cfbird/usb3-sdr/notes/u12sw/u12sw_open.png

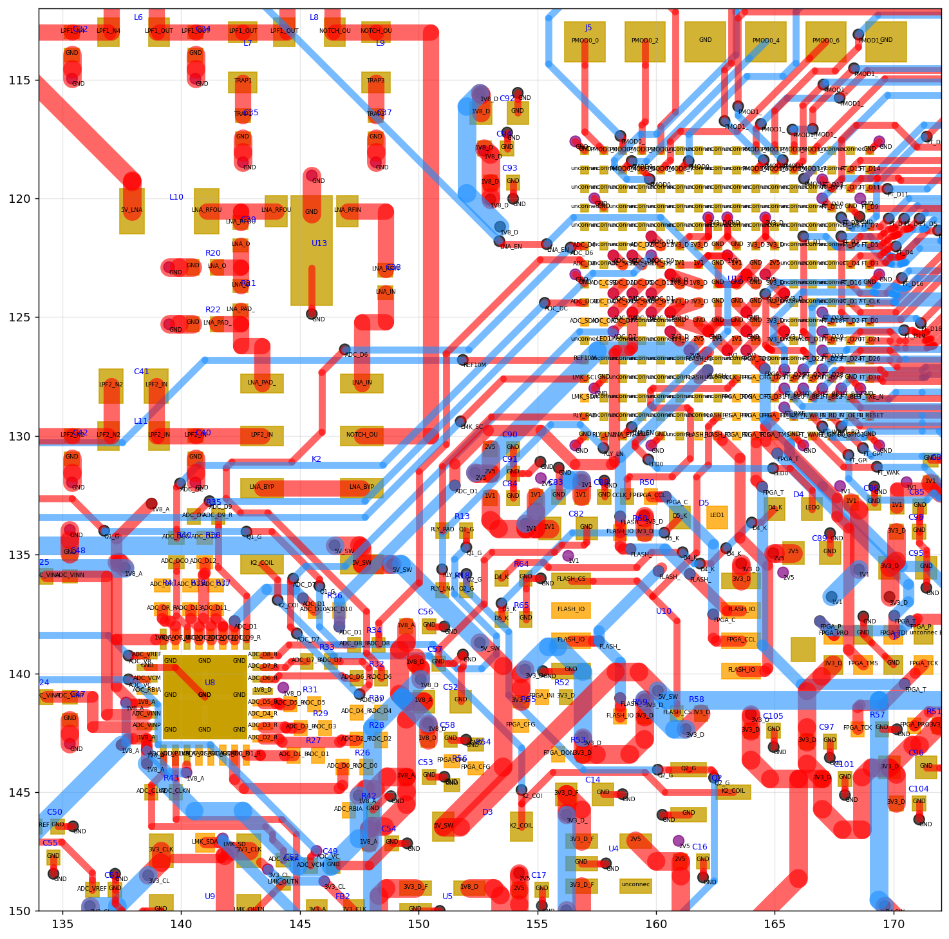
notes/u12sw/u12sw_open.png
