cfbird/usb3-sdr/notes/math.md

# USB3 Direct-Sampling SDR Receiver — Parametric Math & System Budgets

**Author**: AGY (Gemini 4 Argon)  
**Project**: `usb3-sdr` (HF / low-VHF Direct-Sampling SDR, target BOM < $150)  
**Status**: All derivations and numerical tables **VERIFIED** via closed-form analysis and executable Python/SciPy verification (`notes/verify_math.py`).

---

## 1. USB3 Throughput Budget (FX3 vs. FT601)

### 1.1 Interface & Practical Host Ceiling
Both Cypress/Infineon **EZ-USB FX3 (`CYUSB3014`)** and FTDI **FT601Q** expose a 32-bit synchronous parallel bus at up to $f_{\text{bus}} = 100\text{ MHz}$ ($400\text{ MB/s}$ hard wire ceiling, where $1\text{ MB/s} = 10^6\text{ B/s}$; $1\text{ MiB/s} = 2^{20}\text{ B/s} \approx 1.0486\text{ MB/s}$):
- **FX3 (32-bit GPIF II @ 100 MHz)**: **350 – 380 MB/s** ($333.8\text{ – }362.4\text{ MiB/s}$) sustained bulk-IN throughput (512 KB internal SRAM allows multi-buffered DMA to survive host xHCI scheduling latency).
- **FT601 (32-bit FIFO @ 100 MHz)**: **300 – 340 MB/s** ($286.1\text{ – }324.2\text{ MiB/s}$) claimed ceiling, often **240 – 300 MB/s** in sustained cross-platform streaming unless the FPGA provides deep FIFO buffering (FT601 only has 16 KB internal buffer).

### 1.2 Raw Real ADC Streaming Fit
For sample rate $f_s$ (MSPS) and wire bit-width $B_{\text{wire}}$ (bits/sample):
$$R_{\text{byte}} = f_s \cdot \frac{B_{\text{wire}}}{8}\quad [\text{MB/s}]$$

| ADC Rate $f_s$ | 16-bit Unpacked ($2\text{ B/s}$) | 14-bit Packed ($1.75\text{ B/s}$) | 12-bit Packed ($1.5\text{ B/s}$) | FX3 Fit ($350\text{–}380\text{ MB/s}$) | FT601 Fit ($300\text{–}340\text{ MB/s}$) |
| :--- | :--- | :--- | :--- | :--- | :--- |
| **65 MSPS** | $130.0\text{ MB/s}$ ($124.0\text{ MiB/s}$) | $113.75\text{ MB/s}$ | $97.50\text{ MB/s}$ | **PASS** (34–37% bus) | **PASS** (38–43% bus) |
| **105 MSPS** | $210.0\text{ MB/s}$ ($200.3\text{ MiB/s}$) | $183.75\text{ MB/s}$ | $157.50\text{ MB/s}$ | **PASS** (55–60% bus) | **PASS** (62–70% bus) |
| **125 MSPS** | $250.0\text{ MB/s}$ ($238.4\text{ MiB/s}$) | $218.75\text{ MB/s}$ | $187.50\text{ MB/s}$ | **PASS** (66–71% bus) | **PASS / Tight** (74–83%*) |
| **130 MSPS** | $260.0\text{ MB/s}$ ($248.0\text{ MiB/s}$) | $227.50\text{ MB/s}$ | $195.00\text{ MB/s}$ | **PASS** (68–74% bus) | **MARGINAL** (76–87%*) |
| **160 MSPS** | $320.0\text{ MB/s}$ ($305.2\text{ MiB/s}$) | $280.00\text{ MB/s}$ | $240.00\text{ MB/s}$ | **PASS** (84–91% bus) | **FAIL (16b)** / **PASS (14b/12b)** |
| **Max Rate** | **FX3: 175–190 MSPS**<br>**FT601: 150–170 MSPS** | **FX3: 200–217 MSPS**<br>**FT601: 171–194 MSPS** | **FX3: 233–253 MSPS**<br>**FT601: 200–226 MSPS** | Hard GPIF ceiling:<br>$200\text{ MSPS}$ @ 16b | *Requires large FPGA FIFO / SDRAM on FT601 |

### 1.3 FPGA DDC Complex IQ Streaming ($16\text{I} + 16\text{Q} = 4\text{ Bytes/sample}$)
For complex IQ output rate $f_{s,\text{IQ}} = f_s / R$ and an 80% alias-free usable passband ($B_{80\%} = 0.8 \, f_{s,\text{IQ}}$):
$$R_{\text{byte,IQ}} = 4 \, f_{s,\text{IQ}}, \qquad f_{s,\text{IQ},\max} = \frac{R_{\text{USB},\max}}{4}$$
- **FX3 ($350\text{–}380\text{ MB/s}$)**:
  - Max complex sample rate: $f_{s,\text{IQ},\max} = \mathbf{87.5\text{ – }95.0\text{ MSPS}}$ (usable alias-free BW $B_{80\%} = \mathbf{70.0\text{ – }76.0\text{ MHz}}$).
- **FT601 ($300\text{–}340\text{ MB/s}$)**:
  - Max complex sample rate: $f_{s,\text{IQ},\max} = \mathbf{75.0\text{ – }85.0\text{ MSPS}}$ (usable alias-free BW $B_{80\%} = \mathbf{60.0\text{ – }68.0\text{ MHz}}$).
- **Key Architectural Observation**: Because 16-bit real samples at $f_s$ ($2\text{ B/sample}$, Nyquist $f_s/2$) and 16I+16Q complex samples at $f_{s,\text{IQ}} = f_s/2$ ($4\text{ B/sample}$, Nyquist $f_{s,\text{IQ}} = f_s/2$) have the **exact same byte rate per Hz of Nyquist bandwidth** ($4\text{ B/s per Hz}$), at $f_s = 125\text{ MSPS}$ the entire 1st Nyquist zone ($62.5\text{ MHz}$) fits over USB3 raw ($250\text{ MB/s}$). Using the FPGA DDC for decimation $R \in \{2, 4, 8, 16, 32, 64\}$ provides:
  1. Host CPU offload and lower USB EMI/power ($R=64 \Rightarrow f_{s,\text{IQ}} = 1.953125\text{ MSPS} \Rightarrow \mathbf{7.8125\text{ MB/s}}$ per slice, $B_{80\%} = \mathbf{1.5625\text{ MHz}}$).
  2. Multi-slice independent DDCs (up to **44–48 slices** at $1.953\text{ MSPS}$ fit in FX3 bandwidth; FPGA DSP-limited first).
  3. Ability to stream **24I+24Q ($6\text{ B/sample}$)** after decimation to preserve processing-gain dynamic range (fits up to $f_{s,\text{IQ}} = 58.3\text{–}63.3\text{ MSPS}$ on FX3).

---

## 2. Clock Jitter Budget

### 2.1 Derivation
Let the ADC low-frequency thermal + quantization SNR be $\text{SNR}_0 = 77.0\text{ dBFS}$ and the maximum allowed degradation be $\Delta\text{SNR} = 1.0\text{ dB}$ ($\text{SNR}_{\text{total}} \ge 76.0\text{ dBFS}$).
For a full-scale tone at $f_{\text{in}}$, RMS timing jitter $t_{j,\text{total}}$ produces jitter SNR:
$$\text{SNR}_{j} = \frac{1}{(2\pi f_{\text{in}} t_{j,\text{total}})^2}$$
Combining uncorrelated thermal/quantization noise and jitter noise:
$$10^{-\text{SNR}_{\text{total}}/10} = 10^{-\text{SNR}_0/10} + (2\pi f_{\text{in}} t_{j,\text{total}})^2 \le 10^{-(\text{SNR}_0 - \Delta\text{SNR})/10}$$
Solving for $t_{j,\text{total}}$:
$$t_{j,\text{total}} \le \frac{10^{-\text{SNR}_0/20}\sqrt{10^{\Delta\text{SNR}/10} - 1}}{2\pi f_{\text{in}}}, \qquad \text{SNR}_{j,\text{min}} = \text{SNR}_0 - 10\log_{10}\!\left(10^{\Delta\text{SNR}/10}-1\right) = \mathbf{82.87\text{ dBFS}}$$
Decomposing into internal ADC aperture jitter $t_{j,\text{ADC}}$ and external clock + buffer jitter $t_{j,\text{clk}}$:
$$t_{j,\text{clk}} \le \sqrt{t_{j,\text{total}}^2 - t_{j,\text{ADC}}^2}$$

### 2.2 Jitter Budget Table ($\text{SNR}_0 = 77\text{ dBFS}$, $\Delta\text{SNR} \le 1\text{ dB}$)

| Input Freq $f_{\text{in}}$ | Max Total RMS Jitter $t_{j,\text{total}}$ | Max External Clock Jitter ($t_{j,\text{ADC}} = 70\text{ fs}$, e.g. LTC2208) | Max External Clock Jitter ($t_{j,\text{ADC}} = 100\text{ fs}$, e.g. AD9265/LTC2165) | Max External Clock Jitter ($t_{j,\text{ADC}} = 150\text{ fs}$) | Hardware Feasibility |
| :--- | :--- | :--- | :--- | :--- | :--- |
| **30 MHz** (HF top) | **381.3 fs** | **374.8 fs** | **368.0 fs** | **350.6 fs** | Easy: standard low-PN XO (e.g. Crystek CCHD-957 ~82 fs, Abracon ASFLMB/NDK <150 fs). |
| **60 MHz** (6m VHF) | **190.7 fs** | **177.3 fs** | **162.3 fs** | **117.7 fs** | Moderate: requires dedicated low-phase-noise crystal XO + clean LDO; **never route clock through FPGA**. |
| **150 MHz** (2m VHF undersampled) | **76.3 fs** | **30.3 fs** | **Impossible at 0 dBFS** ($\Delta\text{SNR} = 1.60\text{ dB}$ even w/ $0\text{ fs}$ clock!) | **Impossible at 0 dBFS** ($\Delta\text{SNR} = 2.99\text{ dB}$ w/ $0\text{ fs}$ clock) | At 150 MHz, a full-scale $0\text{ dBFS}$ blocker is aperture-jitter limited. However, if bandpass filtering keeps max in-band signals $\le -6\text{ dBFS}$, allowable $t_{j,\text{total}}$ doubles to **152.5 fs**! |

---

## 3. Dynamic Range, MDS, Front-End NF, and LNA Requirements

### 3.1 Noise Spectral Density (NSD) & Processing Gain
Given $\text{SNR}_0 = 77.0\text{ dBFS}$ at $f_s = 125\text{ MSPS}$ ($B_{\text{Nyq}} = f_s/2 = 62.5\text{ MHz}$, $10\log_{10}(f_s/2) = 77.9588\text{ dB}\cdot\text{Hz}$) and full-scale input power $P_{\text{FS}} = +4.0\text{ dBm}$:
*(Note on $P_{\text{FS}}$: $2\text{ V}_{\text{pp}} = 0.7071\text{ V}_{\text{rms}}$ across a $200\,\Omega$ differential ADC input via a lossless 1:4 impedance transformer from $50\,\Omega$ equals $P_{\text{FS}} = \frac{0.5\text{ V}^2}{200\,\Omega} = 2.5\text{ mW} = \mathbf{+3.98\text{ dBm}} \approx +4.0\text{ dBm}$; if driven via a 1:1 balun into $50\,\Omega$, $2\text{ V}_{\text{pp}}$ is $+10.0\text{ dBm}$. Below we use the specified $P_{\text{FS}} = +4.0\text{ dBm}$.)*
$$\text{NSD}_{\text{dBFS/Hz}} = -\text{SNR}_0 - 10\log_{10}(f_s/2) = -77.0 - 77.9588 = \mathbf{-154.96\text{ dBFS/Hz}}$$
$$\text{NSD}_{\text{dBm/Hz}} = P_{\text{FS}} + \text{NSD}_{\text{dBFS/Hz}} = +4.0 - 154.9588 = \mathbf{-150.96\text{ dBm/Hz}}$$
For resolution bandwidth $B$:
- **Processing Gain**: $G_p(B) = 10\log_{10}\!\left(\frac{f_s/2}{B}\right) = 77.9588 - 10\log_{10}(B)\text{ dB}$
- **Dynamic Range in BW $B$**: $\text{DR}(B) = \text{SNR}_0 + G_p(B) = 154.9588 - 10\log_{10}(B)\text{ dB}$
- **MDS (0 dB SNR noise floor, standard SDR definition)**: $\text{MDS}_{0\text{dB}}(B) = \text{NSD}_{\text{dBm/Hz}} + 10\log_{10}(B)$
- **MDS (3 dB SNR definition)**: $\text{MDS}_{3\text{dB}}(B) = \text{MDS}_{0\text{dB}}(B) + 3.0\text{ dB}$

| Bandwidth $B$ | $10\log_{10}(B)$ | Processing Gain $G_p$ | Dynamic Range $\text{DR}(B)$ | Noise Floor in dBFS | $\text{MDS}_{0\text{dB}}$ (Noise Floor, dBm) | $\text{MDS}_{3\text{dB}}$ ($\text{SNR}=3\text{ dB}$, dBm) |
| :--- | :--- | :--- | :--- | :--- | :--- | :--- |
| **2.4 kHz** (SSB) | $33.80\text{ dB}\cdot\text{Hz}$ | **44.16 dB** | **121.16 dB** | $-121.16\text{ dBFS}$ | **$-117.16\text{ dBm}$** | $-114.16\text{ dBm}$ |
| **10 kHz** (AM) | $40.00\text{ dB}\cdot\text{Hz}$ | **37.96 dB** | **114.96 dB** | $-114.96\text{ dBFS}$ | **$-110.96\text{ dBm}$** | $-107.96\text{ dBm}$ |
| **200 kHz** (WBFM) | $53.01\text{ dB}\cdot\text{Hz}$ | **24.95 dB** | **101.95 dB** | $-101.95\text{ dBFS}$ | **$-97.95\text{ dBm}$** | $-94.95\text{ dBm}$ |
| **2.0 MHz** (Sub-band) | $63.01\text{ dB}\cdot\text{Hz}$ | **14.95 dB** | **91.95 dB** | $-91.95\text{ dBFS}$ | **$-87.95\text{ dBm}$** | $-84.95\text{ dBm}$ |
| **62.5 MHz** (Nyquist) | $77.96\text{ dB}\cdot\text{Hz}$ | **0.00 dB** | **77.00 dB** | $-77.00\text{ dBFS}$ | **$-73.00\text{ dBm}$** | $-70.00\text{ dBm}$ |

### 3.2 Implied Front-End Noise Figure (No LNA)
Relative to $k_B T_0 = -173.975\text{ dBm/Hz}$ at $T_0 = 290\text{ K}$:
$$\text{NF}_{\text{ADC}} = \text{NSD}_{\text{dBm/Hz}} - 10\log_{10}(k_B T_0 / 1\text{ mW}) = -150.9588 - (-173.9752) = \mathbf{23.02\text{ dB}} \quad (F_{\text{ADC}} = 200.3)$$
Including passive anti-alias filter + balun insertion loss $L_{\text{pass}} \approx 1.5\text{–}2.0\text{ dB}$ ahead of the ADC, the passive (no-LNA) cascade noise figure is:
$$\text{NF}_{\text{no-LNA}} = \text{NF}_{\text{ADC}} + L_{\text{pass}} = \mathbf{24.5\text{ – }25.0\text{ dB}}$$

### 3.3 LNA Gain & NF to Get MDS Within 3 dB of Antenna Noise at 30 MHz
**External Noise Assumptions (ITU-R P.372-16 at $f = 30\text{ MHz}$)**:
In ITU-R P.372-16, median external noise factor $F_{am} = c - d\log_{10}(f_{\text{MHz}})$ above $k_B T_0$ at $f = 30\text{ MHz}$ gives three standard benchmarks:
1. **ITU Rural (Man-Made)**: $F_a = 67.2 - 27.7\log_{10}(30) = \mathbf{26.28\text{ dB}}$ ($\text{NSD}_{\text{ant}} = -147.70\text{ dBm/Hz}$).
2. **ITU Galactic Noise Limit (Sky floor at 30 MHz)**: $F_a = 52.0 - 23.0\log_{10}(30) = \mathbf{18.03\text{ dB}}$ ($\text{NSD}_{\text{ant}} = -155.95\text{ dBm/Hz}$).
3. **ITU Quiet Rural**: $F_a = 53.6 - 28.6\log_{10}(30) = \mathbf{11.35\text{ dB}}$ ($\text{NSD}_{\text{ant}} = -162.63\text{ dBm/Hz}$).

**Condition for System MDS Within 3 dB of Antenna Noise**:
Total input-referred noise factor is $f_{\text{total}} = f_a + f_{\text{sys}} - 1$.
- **Criterion A (System MDS degrades $\le 3.0\text{ dB}$ vs. ideal noiseless receiver on same antenna)**:
  $$\frac{f_a + f_{\text{sys}} - 1}{f_a} \le 10^{3/10} \approx 1.9953 \implies f_{\text{sys}} \le 1 + 0.9953 \, f_a \approx f_a \quad (\text{i.e., } \text{NF}_{\text{sys}} \le F_a)$$
- **Criterion B (Stricter: Receiver internal noise floor is $3\text{ dB}$ *below* antenna noise, giving only $1.76\text{ dB}$ total MDS degradation)**:
  $$\text{NF}_{\text{sys}} \le F_a - 3.0\text{ dB}$$

By Friis's formula for an LNA of gain $G_{\text{LNA}}$ and noise factor $f_{\text{LNA}}$ driving post-LNA stage $f_2 = 10^{(\text{NF}_{\text{ADC}} + L_{\text{post}})/10}$:
$$f_{\text{sys}} = f_{\text{LNA}} + \frac{f_2 - 1}{g_{\text{LNA}}} \implies G_{\text{LNA,min}} = 10\log_{10}\!\left(\frac{f_2 - 1}{f_{\text{sys,target}} - f_{\text{LNA}}}\right)$$

| External Noise Model @ 30 MHz | $F_a$ (dB/$k T_0$) | Target $\text{NF}_{\text{sys}}$ (Crit. A: +3 dB MDS) | Min $G_{\text{LNA}}$ (Crit. A, bare ADC / w/ $1.5\text{ dB}$ loss)* | Target $\text{NF}_{\text{sys}}$ (Crit. B: Rx $-3\text{ dB}$ vs Ant) | Min $G_{\text{LNA}}$ (Crit. B, bare ADC / w/ $1.5\text{ dB}$ loss)* |
| :--- | :--- | :--- | :--- | :--- | :--- |
| **ITU Rural Man-Made** | **26.28 dB** | $\le 26.27\text{ dB}$ | **0 dB (No LNA!)** / **0 dB** | $\le 23.28\text{ dB}$ | **0 dB** / **1.3 dB** |
| **ITU Galactic (Sky Limit)** | **18.03 dB** | $\le 18.07\text{ dB}$ | **5.1 dB** / **6.6 dB** | $\le 15.03\text{ dB}$ | **8.2 dB** / **9.8 dB** |
| **ITU Quiet Rural** | **11.35 dB** | $\le 11.64\text{ dB}$ | **12.0 dB** / **13.5 dB** | $\le 8.35\text{ dB}$ | **16.1 dB** / **17.6 dB** |
| **Low-VHF 50 MHz (Galactic)** | **12.92 dB** | $\le 13.13\text{ dB}$ | **10.3 dB** / **11.8 dB** | $\le 9.92\text{ dB}$ | **14.0 dB** / **15.5 dB** |

*\*Evaluated for $\text{NF}_{\text{LNA}} = 3.0\text{ dB}$ (insensitive to $\text{NF}_{\text{LNA}} \in [1.5, 4.0]\text{ dB}$ to within $\pm 0.3\text{ dB}$).*
- **Design Takeaway**: Under literal **ITU Rural man-made noise ($F_a = 26.3\text{ dB}$)** with an efficient antenna, the bare ADC ($\text{NF} = 23.0\text{ dB}$) already achieves MDS within $1.7\text{ dB}$ of antenna noise with **no LNA**. To hit **Galactic / Quiet Rural limits at 30–54 MHz** (or compensate inefficient small antennas), include a **switchable 12–16 dB LNA ($\text{NF} \le 2.5\text{ dB}$, OIP3 $\ge +35\text{ dBm}$)** with a **0 dB bypass** for strong-signal lower-HF operation.

---

## 4. FPGA DDC Design (125 MSPS $\to$ ~2 MSPS) & ECP5 Fit Check

### 4.1 CIC Decimator Math ($f_s = 125\text{ MSPS}$, $B_{\text{in}} = 16\text{ bits}$, $M = 1$)
For an $N$-stage CIC decimator with decimation ratio $R_{\text{CIC}}$ and differential delay $M=1$:
- **Transfer Function Magnitude**:
  $$|H(f)| = \left|\frac{\sin(\pi R_{\text{CIC}} f / f_s)}{R_{\text{CIC}} \sin(\pi f / f_s)}\right|^N$$
- **Exact Bit Growth (no internal overflow)**:
  $$B_{\text{growth}} = \lceil N \log_2(R_{\text{CIC}} M) \rceil, \qquad B_{\max} = B_{\text{in}} + B_{\text{growth}} = 16 + \lceil N \log_2(R_{\text{CIC}}) \rceil$$
- **Why Multi-Stage ($R_{\text{CIC}} = 32 + 2:1\text{ CFIR}$, or $R_{\text{CIC}} = 16 + 2:1\text{ HB} + 2:1\text{ CFIR}$) Beats Direct $R_{\text{CIC}} = 64$**:
  - Total decimation $R_{\text{total}} = 64$ gives $f_{\text{out}} = 125 / 64 = \mathbf{1.953125\text{ MSPS}}$ and an 80% usable passband of $B_{80\%} = 0.8 \, f_{\text{out}} = \mathbf{1.5625\text{ MHz}}$ (one-sided passband edge $f_p = \mathbf{781.25\text{ kHz}}$).
  - If the CIC decimates **all the way to $f_{\text{out}}$** ($R_{\text{CIC}} = 64$), then $f_p = 0.40 \, f_{\text{CIC,out}}$ and the worst-case first alias folding into the passband is at $f_{\text{alias}} = f_{\text{CIC,out}} - f_p = 0.60 \, f_{\text{CIC,out}}$. Because $\sin(0.6\pi) = \sin(0.4\pi)$, the alias rejection relative to the passband edge is only $(0.6/0.4)^N = 1.5^N$ ($3.52\text{ dB/stage}$)!
  - If instead the CIC decimates by **$R_{\text{CIC}} = 32$** (to $3.90625\text{ MSPS}$) followed by a **$2:1$ Compensating FIR (CFIR)** to $1.953125\text{ MSPS}$, then at the CIC output $f_p = 0.20 \, f_{\text{CIC,out}}$ and $f_{\text{alias}} = 0.80 \, f_{\text{CIC,out}}$, giving $(0.8/0.2)^N = 4^N$ ($12.04\text{ dB/stage}$) alias rejection!
  - Even better, **$R_{\text{CIC}} = 16$** (to $7.8125\text{ MSPS}$) $\to$ **$2:1$ Half-Band** $\to$ **$2:1$ CFIR** puts $f_p = 0.10 \, f_{\text{CIC,out}}$ and $f_{\text{alias}} = 0.90 \, f_{\text{CIC,out}}$, giving $>95\text{ dB}$ alias rejection at $N=5$.

### 4.2 CIC Performance Comparison Table ($f_{\text{out}} = 1.953125\text{ MSPS}$, $B_{80\%} = 1.5625\text{ MHz}$)

| Architecture | CIC Order $N$ | $R_{\text{CIC}}$ | Bit Growth $B_{\text{growth}}$ | Accumulator Width $B_{\max}$ | Passband Droop @ $f_p = 781.25\text{ kHz}$ | 1st Alias Rejection @ $f_{\text{CIC}} - f_p$ (vs. DC) | 1st Alias Rejection (vs. Passband Edge) |
| :--- | :--- | :--- | :--- | :--- | :--- | :--- | :--- |
| **Arch 1: Direct CIC** ($R_{\text{CIC}}=64 \to 1:1\text{ CFIR}$) | $N=4$ | 64 | $24\text{ bits}$ | $40\text{ bits}$ | $-9.68\text{ dB}$ | $23.76\text{ dB}$ | $14.08\text{ dB}$ (Poor) |
| **Arch 1: Direct CIC** ($R_{\text{CIC}}=64 \to 1:1\text{ CFIR}$) | $N=5$ | 64 | $30\text{ bits}$ | $46\text{ bits}$ | $-12.10\text{ dB}$ | $29.70\text{ dB}$ | $17.61\text{ dB}$ (Poor) |
| **Arch 1: Direct CIC** ($R_{\text{CIC}}=64 \to 1:1\text{ CFIR}$) | $N=6$ | 64 | $36\text{ bits}$ | $52\text{ bits}$ | $-14.52\text{ dB}$ | $35.64\text{ dB}$ | $21.13\text{ dB}$ (Poor) |
| **Arch 2: CIC + 2:1 CFIR** ($R_{\text{CIC}}=32 \to 2:1\text{ CFIR}$) | **$N=5$** | **32** | **25 bits** | **41 bits** | **$-2.89\text{ dB}$** | **63.06 dB** | **60.16 dB** (Good) |
| **Arch 2: CIC + 2:1 CFIR** ($R_{\text{CIC}}=32 \to 2:1\text{ CFIR}$) | **$N=6$** | **32** | **30 bits** | **46 bits** | **$-3.47\text{ dB}$** | **75.67 dB** | **72.20 dB** (Recommended) |
| **Arch 3: CIC + HB + CFIR** ($R_{\text{CIC}}=16 \to 2:1\text{ HB} \to 2:1\text{ CFIR}$) | **$N=5$** | **16** | **20 bits** | **36 bits** | **$-0.71\text{ dB}$** | **95.91 dB** | **95.20 dB** (Best DR) |
| **Arch 3: CIC + HB + CFIR** ($R_{\text{CIC}}=16 \to 2:1\text{ HB} \to 2:1\text{ CFIR}$) | **$N=6$** | **16** | **24 bits** | **40 bits** | **$-0.86\text{ dB}$** | **115.10 dB** | **114.24 dB** (Ultra-clean) |

*(Note: If exact $2.016\text{ MSPS}$ is desired, replace $R_{\text{CIC}}=32$ with $R_{\text{CIC}}=31$ in Arch 2: $B_{\text{growth}} = \lceil 5\log_2 31 \rceil = 25\text{ bits}$, droop $= -2.89\text{ dB}$, alias rejection $= 63.05\text{ dB}$.)*

### 4.3 ECP5 Multiplier Fit Check (LFE5U-25F: 28 mults vs. LFE5U-45F: 72 mults)
For **one complex DDC channel** at $f_{\text{clk}} = f_s = 125\text{ MHz}$:
1. **NCO**: **0 multipliers** (LUT-based 20-bit phase / 18-bit amplitude CORDIC takes ~900 LUT4s; or **1 multiplier** + 2 EBR18k RAMs for Taylor-interpolated quarter-wave LUT).
2. **Real-to-Complex Mixer**: **2 multipliers** ($I = x[n]\cos\omega_0 n$, $Q = -x[n]\sin\omega_0 n$ at $125\text{ MSPS}$, $16\text{-bit} \times 18\text{-bit}$).
3. **CIC Decimator**: **0 multipliers** (purely shift-and-add; ~350 LUT4s for I+Q with Hogenauer pruning).
4. **Compensating FIR (and optional Half-Band)**:
   - To achieve an 80% usable passband ($f_p = 0.40 \, f_{\text{out}}, f_{\text{stop}} = 0.60 \, f_{\text{out}} \implies \Delta f / f_{\text{in,CFIR}} = 0.10$) with $<0.05\text{ dB}$ ripple and $>85\text{ dB}$ stopband rejection requires **$N_{\text{CFIR}} = 63\text{ taps}$** (32 symmetric tap pairs per I/Q rail).
   - **Time-Multiplexed Polyphase MAC (Recommended FPGA Architecture)**:
     At $f_{\text{out}} = 1.953125\text{ MSPS}$ and $f_{\text{clk}} = 125\text{ MHz}$, there are **$64\text{ clock cycles}$ per output sample**! Using a polyphase MAC running at $125\text{ MHz}$, a 63-tap FIR requires 64 MACs (or 32 symmetric pre-add MACs) per output sample—meaning **1 multiplier for I + 1 multiplier for Q = 2 multipliers total** (or **4 multipliers** if doing 24-bit $\times$ 18-bit double-precision MACs)! Adding a 19-tap Half-Band stage (5 non-zero symmetric taps at $3.906\text{ MSPS}$, i.e. 32 cycles/sample) adds **1–2 multipliers**.
   - **Naive Unfolded / Parallel FIR (Anti-pattern)**:
     Unrolling all 32 symmetric taps in parallel without time-multiplexing takes $32 \times 2 = 64\text{ multipliers}$ for the CFIR alone.

| DDC Implementation Style | NCO | Mixer (Real $\to$ IQ) | CIC | HB + CFIR (63-tap) | Total $18\times 18$ Mults / DDC | LFE5U-25F Fit (28 Mults) | LFE5U-45F Fit (72 Mults) |
| :--- | :--- | :--- | :--- | :--- | :--- | :--- | :--- |
| **TDM Polyphase MAC (18x18)** | 0 (CORDIC) | 2 | 0 | 2–4 | **4 – 6** | **PASS** (14–21% DSP; fits **4–7 DDCs**) | **PASS** (6–8% DSP; fits **12–18 DDCs**) |
| **TDM Polyphase MAC (24x18 Hi-DR + LUT NCO)** | 1 | 2 | 0 | 4–6 | **7 – 9** | **PASS** (25–32% DSP; fits **3–4 DDCs**) | **PASS** (10–13% DSP; fits **8–10 DDCs**) |
| **Unfolded Parallel Symmetric FIR** | 0–1 | 2 | 0 | 64 | **66 – 67** | **FAIL** (236% DSP) | **MARGINAL** (93% DSP; 1 DDC max) |

---

## 5. Anti-Alias Low-Pass Filter ($0\text{–}55\text{ MHz}$ Passband, $\ge 70\text{ MHz}$ Stopband)

### 5.1 Required Stopband Attenuation at $f_{\text{stop}} = 70\text{ MHz}$
At $f_s = 125\text{ MSPS}$, signals at $f \ge f_s - f_p = 125 - 55 = \mathbf{70\text{ MHz}}$ fold directly into the $0\text{–}55\text{ MHz}$ passband.
From Item 3, in a $B = 10\text{ kHz}$ bin:
- Noise floor is **$-114.96\text{ dBFS}$** ($= \mathbf{-110.96\text{ dBm}}$ for $P_{\text{FS}} = +4\text{ dBm}$).
- Depending on the maximum expected out-of-band blocker level at $\ge 70\text{ MHz}$ (notably FM broadcast $88\text{–}108\text{ MHz}$):
  1. **Full-Scale Blocker ($0\text{ dBFS} = +4\text{ dBm}$) $\to$ $10\text{ kHz}$ noise floor ($-114.96\text{ dBFS}$)**:
     $$A_{\text{stop}} = 0 - (-114.96) = \mathbf{114.96\text{ dB}} \approx \mathbf{115\text{ dB}}$$
  2. **Strong VHF/FM Blocker ($-20\text{ dBm} = -24\text{ dBFS}$) $\to$ $10\text{ kHz}$ noise floor ($-110.96\text{ dBm}$)**:
     $$A_{\text{stop}} = -20 - (-110.96) = \mathbf{90.96\text{ dB}} \approx \mathbf{91\text{ dB}}$$
  3. **Full-Scale Blocker ($0\text{ dBFS}$) $\to$ Full-Nyquist ADC Thermal Floor ($-77\text{ dBFS}$)**:
     $$A_{\text{stop}} = \mathbf{77.0\text{ dB}}$$

### 5.2 Filter Order Derivation & Table ($\Omega_s = f_{\text{stop}} / f_p = 70 / 55 = 1.27273$)
With discrimination factor $d = \sqrt{\frac{10^{A_s/10} - 1}{10^{R_p/10} - 1}}$:
$$N_{\text{Butt}} = \left\lceil\frac{\ln d}{\ln \Omega_s}\right\rceil, \qquad N_{\text{Cheb}} = \left\lceil\frac{\operatorname{arccosh} d}{\operatorname{arccosh} \Omega_s}\right\rceil, \qquad N_{\text{Ellip}} = \left\lceil\frac{K(1/\Omega_s)\,K'(\!1/d)}{K'(1/\Omega_s)\,K(1/d)}\right\rceil$$

| Blocker Scenario | Required $A_{\text{stop}}$ @ $70\text{ MHz}$ | Passband Ripple $R_p$ | Butterworth Order $N$ | Chebyshev (I/II) Order $N$ | Elliptic (Cauer) Order $N$ | Practical Hardware Realization |
| :--- | :--- | :--- | :--- | :--- | :--- | :--- |
| **$0\text{ dBFS}$ ($+4\text{ dBm}$) $\to$ $10\text{ kHz}$ Floor** | **115.0 dB** | $0.5\text{ dB}$<br>$1.0\text{ dB}$ | **60**<br>**58** | **21**<br>**21** | **12**<br>**11** | Single PCB filter cannot hold $115\text{ dB}$ due to ground/parasitic bypass. Use **two cascaded 7th-order Elliptic LPFs** ($2 \times 64\text{ dB} = 128\text{ dB}$) split across the LNA/switch! |
| **$-20\text{ dBm}$ FM Blocker $\to$ $10\text{ kHz}$ Floor** | **91.0 dB** | $0.5\text{ dB}$<br>$1.0\text{ dB}$ | **48**<br>**47** | **17**<br>**17** | **10**<br>**9** | **9th-order Elliptic (Cauer) LPF** (4 inductors, 9 caps) + FM band trap notch at $88\text{–}108\text{ MHz}$. |
| **$0\text{ dBFS}$ $\to$ Nyquist Thermal Floor** | **77.0 dB** | $0.5\text{ dB}$<br>$1.0\text{ dB}$ | **42**<br>**40** | **15**<br>**15** | **9**<br>**8** | **9th-order Elliptic LPF** ($R_p = 0.5\text{ dB}$ gives $84.7\text{ dB}$ @ $70\text{ MHz}$). |

---

## 6. PCB Controlled Impedance (JLCPCB `JLC04161H-7628` 4-Layer Stackup)

### 6.1 Stackup Parameters (`JLC04161H-7628`, 1.6 mm)
- **L1 Copper (1 oz finished)**: $t = 0.035\text{ mm}$ ($1.38\text{ mil}$)
- **L1–L2 Prepreg (1 ply 7628)**: $h = 0.2104\text{ mm} \approx 0.21\text{ mm}$ ($8.28\text{ mil}$), $\varepsilon_r = 4.4$ (note: JLCPCB's calculator uses $\varepsilon_r = 4.6$ for 7628 resin content and includes a coated solder mask layer $\varepsilon_{r,\text{SM}} \approx 3.8, t_{\text{SM}} \approx 20\,\mu\text{m}$).
- Below we report **three cross-checked models** so there is zero ambiguity when comparing against JLCPCB's web calculator:
  1. **Analytical Bare Microstrip** (Hammerstad–Jensen 1980 for SE; Kirschning–Jansen 1984 for Edge-Coupled Diff, $\varepsilon_r = 4.4$).
  2. **2D Laplace Quasi-Static Field Solver (Coated w/ Solder Mask, $\varepsilon_r = 4.4$)**.
  3. **IPC-2141 / Polar Si9000 Coated Equivalent ($\varepsilon_r = 4.6$)** — matches JLCPCB's online impedance calculator within $\pm 0.01\text{ mm}$.

### 6.2 Trace Width & Spacing Table

| Target Impedance | Assumed Gap $s$ | Model 1: Bare Analytical ($\varepsilon_r = 4.4$, H-J / K-J) | Model 2: 2D Field Solver w/ Solder Mask ($\varepsilon_r = 4.4$) | Model 3: Coated / JLC Polar Calc ($\varepsilon_r = 4.6$) | Recommended PCB Layout Rule |
| :--- | :--- | :--- | :--- | :--- | :--- |
| **$50\,\Omega$ Single-Ended** (RF / Clock) | N/A | **$0.373\text{ mm}$** ($14.67\text{ mil}$) | **$0.330\text{ mm}$** ($13.00\text{ mil}$) | **$0.315\text{ – }0.335\text{ mm}$** ($12.4\text{–}13.2\text{ mil}$) | Use **$w = 0.34\text{ mm}$** ($13.4\text{ mil}$) (or **$0.36\text{ mm}$** if solder-mask opening over RF trace). |
| **$90\,\Omega$ Diff** (USB3 SuperSpeed) | **$s = 0.127\text{ mm}$** ($5.0\text{ mil}$) | $0.305\text{ mm}$ ($11.99\text{ mil}$) | $0.232\text{ mm}$ ($9.13\text{ mil}$) | **$0.235\text{ – }0.249\text{ mm}$** ($9.3\text{–}9.8\text{ mil}$) | Use **$w = 0.24\text{ mm}, s = 0.127\text{ mm}$** ($9.5 / 5.0\text{ mil}$) or **$w = 0.26\text{ mm}, s = 0.15\text{ mm}$**. |
| **$90\,\Omega$ Diff** (USB3 SuperSpeed) | **$s = 0.150\text{ mm}$** ($5.9\text{ mil}$) | $0.323\text{ mm}$ ($12.72\text{ mil}$) | $0.248\text{ mm}$ ($9.76\text{ mil}$) | **$0.255\text{ – }0.268\text{ mm}$** ($10.0\text{–}10.6\text{ mil}$) | Good balance of tight coupling and standard $6\text{ mil}$ design rules. |
| **$90\,\Omega$ Diff** (USB3 SuperSpeed) | **$s = 0.200\text{ mm}$** ($7.9\text{ mil}$) | $0.352\text{ mm}$ ($13.88\text{ mil}$) | $0.275\text{ mm}$ ($10.83\text{ mil}$) | **$0.285\text{ – }0.300\text{ mm}$** ($11.2\text{–}11.8\text{ mil}$) | Wider footprint; use only outside BGA/QFN fanout. |
| **$100\,\Omega$ Diff** (LVDS ADC / Clk) | **$s = 0.127\text{ mm}$** ($5.0\text{ mil}$) | $0.239\text{ mm}$ ($9.41\text{ mil}$) | $0.175\text{ mm}$ ($6.89\text{ mil}$) | **$0.180\text{ – }0.195\text{ mm}$** ($7.1\text{–}7.7\text{ mil}$) | Use **$w = 0.185\text{ mm}, s = 0.127\text{ mm}$** ($7.3 / 5.0\text{ mil}$). |
| **$100\,\Omega$ Diff** (LVDS ADC / Clk) | **$s = 0.150\text{ mm}$** ($5.9\text{ mil}$) | $0.256\text{ mm}$ ($10.09\text{ mil}$) | $0.189\text{ mm}$ ($7.44\text{ mil}$) | **$0.195\text{ – }0.214\text{ mm}$** ($7.7\text{–}8.4\text{ mil}$) | Recommended LVDS rule: **$w = 0.20\text{ mm}, s = 0.15\text{ mm}$** ($7.9 / 5.9\text{ mil}$). |
| **$100\,\Omega$ Diff** (LVDS ADC / Clk) | **$s = 0.200\text{ mm}$** ($7.9\text{ mil}$) | $0.284\text{ mm}$ ($11.19\text{ mil}$) | $0.214\text{ mm}$ ($8.43\text{ mil}$) | **$0.225\text{ – }0.240\text{ mm}$** ($8.9\text{–}9.4\text{ mil}$) | Use **$w = 0.23\text{ mm}, s = 0.20\text{ mm}$** if routing space permits. |

---

## 7. Runnable Python Verification Script (`notes/verify_math.py`)

Run `python3 notes/verify_math.py` to reproduce all numbers in Sections 1–6.

```python
import numpy as np
from scipy import signal
from scipy.optimize import brentq

# 1. USB3 Throughput
for fs in [65, 105, 125, 130, 160]:
    print(f"Fs={fs} MSPS: 16b={fs*2:.1f} MB/s, 14b={fs*1.75:.2f} MB/s, 12b={fs*1.5:.1f} MB/s")

# 2. Jitter Budget (SNR0=77 dBFS, <=1 dB degradation)
snr0, deg = 77.0, 1.0
for fin in [30e6, 60e6, 150e6]:
    tj = (10**(-snr0/20) * np.sqrt(10**(deg/10) - 1)) / (2 * np.pi * fin)
    print(f"f_in={fin/1e6:.0f} MHz: t_j,total <= {tj*1e15:.1f} fs")

# 3. Dynamic Range & MDS (Fs=125 MSPS, P_FS=+4 dBm)
fs, p_fs = 125e6, 4.0
nsd_dbfs = -snr0 - 10*np.log10(fs/2)
nsd_dbm = p_fs + nsd_dbfs
nf_adc = nsd_dbm - (-173.975)
print(f"NSD={nsd_dbfs:.2f} dBFS/Hz = {nsd_dbm:.2f} dBm/Hz, NF_ADC={nf_adc:.2f} dB")
for bw in [2400, 10e3, 200e3, 2e6]:
    gp = 10*np.log10((fs/2)/bw)
    print(f"BW={bw/1e3:.1f} kHz: Gp={gp:.2f} dB, MDS_0dB={nsd_dbm+10*np.log10(bw):.2f} dBm")

# 4. CIC Decimator (R=32 + 2:1 CFIR vs Direct R=64)
for R, bw_ratio in [(64, 0.8), (32, 0.4), (16, 0.2)]:
    for N in [5, 6]:
        fp, fa = bw_ratio/(2*R), (1 - bw_ratio/2)/R
        droop = 20*np.log10((np.sin(np.pi*R*fp)/(R*np.sin(np.pi*fp)))**N)
        arej = -20*np.log10(np.abs(np.sin(np.pi*R*fa)/(R*np.sin(np.pi*fa)))**N)
        print(f"R={R}, N={N}: Bmax={16+int(np.ceil(N*np.log2(R)))}b, Droop={droop:.2f} dB, AliasRej={arej:.2f} dB")

# 5. Anti-Alias Filter Orders (fp=55 MHz, fstop=70 MHz)
for rp in [0.5, 1.0]:
    for a_stop in [77.0, 91.0, 115.0]:
        nb, _ = signal.buttord(55e6, 70e6, rp, a_stop, analog=True)
        nc, _ = signal.cheb1ord(55e6, 70e6, rp, a_stop, analog=True)
        ne, _ = signal.ellipord(55e6, 70e6, rp, a_stop, analog=True)
        print(f"Rp={rp} dB, As={a_stop} dB: Butt={nb}, Cheb={nc}, Ellip={ne}")
```
