cfbird/usb3-sdr/notes/round4_gateware_review.md

# Round 4: ECP5 Gateware Adversarial Review (`gateware/`)

**Reviewer**: AGY  
**Target**: `gateware/rtl/*.v`, `gateware/tools/gen_coeffs.py`, `gateware/sim/*`  
**Method**: Cycle-accurate RTL state-machine analysis, exact fixed-point arithmetic bounds, transfer-function derivation, and Python numerical verification against CXXRTL simulation results.

---

## Executive Summary Table

| # | Sub-Item / Module | Verdict | Summary of Findings |
| :--- | :--- | :---: | :--- |
| **1a** | `rtl/nco.v` (ROM, `~ps[11:0]` mirror, phase spurs) | **VERIFIED** | Quarter-wave mirror `~ps[11:0]` is **mathematically exact** because of the $+0.5\text{ LSB}$ half-sample phase offset ($4095 - m \equiv \text{\texttt{\~}}m$). Worst-case phase-truncation spur for $P=14$ bits is **$-84.29\text{ dBc}$**. *(Note: header comment `nco.v:2` says 4-clock latency vs `ddc.v:20` 3-clock; actual `acc` $\to$ `sin_o` is 3 clocks.)* |
| **1b** | `rtl/ddc.v` mixer scaling & `rnd16` | **VERIFIED** | `(pi + 32'sd4096) >>> 13` maps worst-case $(-8192)\times(-131071) = +1{,}073{,}733{,}632 \to \mathbf{+131{,}071 = 2^{17}-1}$, so 18-bit signed `mi, mq` **never overflow** even at `adc = -8192`. `rnd16` (`ddc.v:51-57`) cleanly saturates the $+0.5\text{ LSB}$ rollover at $v \ge +131070$ to `16'sh7fff`. |
| **1c** | `rtl/cic_decim.v` ($N=5, R=16, W=38$, pipelined combs, `sat_round`) | **VERIFIED** | $W = 18 + 5\times 4 = 38\text{ bits}$ is exact Hogenauer growth. Each pipelined comb (`cic_decim.v:37-41`) has decimated transfer function $z_d^{-1}(1 - z_d^{-1})$, giving overall $z_d^{-5}(1 - z_d^{-1})^5 = z^{-80}(1 - z^{-16})^5$: **identically a canonical $N=5, R=16, M=1$ CIC** plus a pure 5-output-sample ($80$-clock) delay. `sat_round` (`cic_decim.v:50-58`) properly sign-extends and saturates. |
| **1d** | `rtl/fir_decim.v` (Q1.17, `AccW`, rounding/sat, back-to-back, circular buffer safety) | **VERIFIED** | `AccW = DW + 18 + AW` ($41\text{b}$ HB, $42\text{b}$ CFIR) has $\ge 6\text{ bits}$ of headroom above max $\sum|h_k|$. Rounding `(res + (1<<<16)) >>> 17` and `sat()` are exact. Pipeline flags `v, f, l` support 0-idle-cycle back-to-back runs. Circular buffer overwrite margins are **9 slots ($136\text{ clks}$)** for HB (`AW=5, NTAPS=23`) and **5 slots ($132\text{ clks}$)** for CFIR (`AW=6, NTAPS=59`). |
| **2** | `tools/gen_coeffs.py` & `-13.22` vs `-12.96 dBFS` tone level | **VERIFIED** | The $0.26\text{ dB}$ discrepancy is **100% explained by Blackman-Harris window scalloping loss** ($-0.2582\text{ dB}$ at $100.000\text{ kHz}$, which lands $\delta = 0.2800\text{ bins}$ off bin $1311$ at $100.021\text{ kHz}$). Exact cascaded filter gain at $100\text{ kHz}$ is $-0.0285\text{ dB}\text{ (CIC)} - 0.0002\text{ dB}\text{ (HB)} + 0.0286\text{ dB}\text{ (CFIR)} = \mathbf{-0.00004\text{ dB}}$. |
| **3** | `rtl/ft601_245.v` replay buffer, pointers, & 1-cycle `TXE_N` claim | **VERIFIED** | 4-bit pointers (`conf, send, fill`) with `fill_lvl < 8` prevent buffer overwrite. Because I/O register capture creates a 2-word in-flight pipeline, `(prev_idx - conf) < (send - conf)` (`ft601_245.v:85`) is essential and prevents a second rejected word from un-rewinding `send`. Exhaustive check confirms **only a 1-cycle `TXE_N`-high pulse** can reorder words, and `prev_idx != conf` (`ft601_245.v:83-84`) deterministically flags `order_err`. |

---

## 1. Detailed Review: DSP Arithmetic (`rtl/nco.v`, `rtl/ddc.v`, `rtl/cic_decim.v`, `rtl/fir_decim.v`)

### 1a. `rtl/nco.v` — Quarter-Wave ROM, Mirroring, and Spur Level (`VERIFIED`)

1. **Exactness of Bitwise-NOT Quarter-Wave Mirror (`nco.v:21-24`, `tools/gen_coeffs.py:45-47`)**:
   - `gen_coeffs.py:46` populates the $4096 \times 18\text{-bit}$ quarter-wave table with a **half-sample phase offset**:
     $$\text{ROM}[k] = \text{round}\!\left((2^{17}-1)\sin\!\left(\frac{2\pi(k + 0.5)}{16384}\right)\right), \quad k \in \{0, 1, \dots, 4095\}$$
   - Let the 14-bit truncated phase be $p = \text{\texttt{acc[31:18]}} = 8192\,q_1 + 4096\,q_0 + m$, where $q_1 = p[13]$ is the sign quadrant bit, $q_0 = p[12]$ is the mirror quadrant bit, and $m = p[11:0] \in [0, 4095]$ is the intra-quadrant index.
   - In the second and fourth quadrants ($q_0 = 1$), the desired half-offset sine argument (modulo $\pi$) is:
     $$\theta(4096 + m) = \frac{2\pi(4096 + m + 0.5)}{16384} = \pi - \frac{2\pi(4095.5 - m)}{16384} = \pi - \frac{2\pi\big((4095 - m) + 0.5\big)}{16384}$$
   - Since $\sin(\pi - x) = \sin(x)$ and for a 12-bit unsigned integer $m \in [0, 4095]$ the bitwise complement is identically $\text{\texttt{\~}}m = 4095 - m$, reading `rom[~ps[11:0]]` (`nco.v:22`) is **mathematically exact** across all four quadrant boundaries ($0, \pi/2, \pi, 3\pi/2$) with zero phase jump and zero DC bias.
   - Cosine is generated via `wire [13:0] pc = ps + 14'd4096;` (`nco.v:19`), which adds exactly $4096 / 16384 = 1/4\text{ cycle}$ ($\pi/2\text{ rad}$) before lookup.

2. **Expected Phase-Truncation Spur Level**:
   - Truncating the 32-bit phase accumulator `acc` to $P = 14$ bits (`acc[31:18]`) with the $+0.5\text{ LSB}_{14}$ ROM offset makes the sawtooth phase-truncation error $\epsilon_\phi \in [-\pi/2^{14}, +\pi/2^{14}]$ symmetric and zero-mean.
   - By the Nicholas–Samueli exact Fourier series for a phase-truncated NCO with $P = 14$ phase bits, the worst-case discrete phase-truncation spur magnitude is:
     $$\text{Spur}_{\text{phase, max}} = 20\log_{10}\!\left(\frac{\pi / 2^P}{\sin(\pi / 2^P)} \cdot 2^{-P}\right) \approx -6.0206\,P = -6.0206 \times 14 = \mathbf{-84.29\text{ dBc}}$$
     matching the `-84 dBc` design comment in `tools/gen_coeffs.py:44`.
   - The 18-bit amplitude quantization ($2^{17}-1 = 131071$) has an SNR of $6.02 \times 18 + 1.76 = 110.1\text{ dB}$, so total NCO SFDR is dominated by the $-84.29\text{ dBc}$ phase-truncation bound (or $110\text{ dBc}$ whenever $\gcd(\text{\texttt{phase\_inc}}, 2^{32}) \ge 2^{18}$).

3. **Minor Comment Mismatch (`nco.v:2` vs. `ddc.v:20`)**:
   - `nco.v:2` states: `// Latency: 4 clocks from phase accumulator to sin/cos.`
   - `ddc.v:20` states: `// NCO has 3 clocks of latency; delay the ADC sample to match.`
   - Tracing `nco.v`: Cycle 1 latches `rs <= rom[as]`, `qs <= ps[13]` (`lines 29-30`); Cycle 2 latches `rs2 <= rs`, `qs2 <= qs` (`lines 31-32`); Cycle 3 latches `sin_o <= qs2 ? -$signed({1'b0, rs2}) : $signed({1'b0, rs2})` (`lines 33-34`). That is **3 clocks** from `acc` (4 clocks from `phase_inc`), matching `ddc.v:20-22` (`adc_d1 -> adc_d2 -> x`).

---

### 1b. `rtl/ddc.v` — Mixer Scaling and Output Rounding (`VERIFIED`)

1. **Mixer Scaling `(pi + 32'sd4096) >>> 13` (`ddc.v:25-31`)**:
   - `x` is 14-bit signed (`[-8192, +8191]`), and `cos_w`, `-sin_w` are 18-bit signed but bounded by the ROM table to `[-131071, +131071]` ($\pm(2^{17}-1)$).
   - Full-scale product is formed in 32-bit signed registers `pi, pq` (`ddc.v:25`):
     - Maximum positive product occurs when `x = -8192` ($-2^{13}$) and `cos_w = -131071` ($-(2^{17}-1)$):
       $$p_{\max} = (-8192) \times (-131071) = +1{,}073{,}733{,}632$$
     - Applying the round-to-nearest shift (`ddc.v:30-31`):
       $$\text{\texttt{mi}} = \left\lfloor \frac{1{,}073{,}733{,}632 + 4096}{8192} \right\rfloor = \left\lfloor \frac{1{,}073{,}737{,}728}{8192} \right\rfloor = \mathbf{+131{,}071 = 2^{17} - 1}$$
     - Minimum negative product occurs when `x = -8192` and `cos_w = +131071`:
       $$p_{\min} = (-8192) \times (+131071) = -1{,}073{,}733{,}632 \implies \left\lfloor \frac{-1{,}073{,}733{,}632 + 4096}{8192} \right\rfloor = \mathbf{-131{,}071 = -(2^{17}-1)}$$
   - Because the ROM peaks at $2^{17}-1$ rather than $2^{17}$, the rounded 18-bit mixer outputs `mi, mq` stay strictly within `[-131071, +131071]` and **cannot overflow 18-bit signed two's complement** (`[-131072, +131071]`) even at full-scale negative ADC input (`-8192`) without needing a saturator.

2. **Output Rounding `rnd16` (`ddc.v:51-57`)**:
   - `t = {v[17], v} + 19'sd2;` sign-extends 18-bit `v` to 19 bits and adds $+0.5\text{ LSB}_{16}$ ($+2$).
   - Positive overflow into $+131072$ occurs only for $v \in \{+131070, +131071\}$, where `t[18:17]` transitions from `2'b00` to `2'b01`. The ternary `(t[18:17] == 2'b01) ? 16'sh7fff : t[17:2]` (`ddc.v:55`) catches this exact condition and saturates to $+32767$.

---

### 1c. `rtl/cic_decim.v` — $N=5, R=16, W=38$, Pipelined Combs, and `sat_round` (`VERIFIED`)

1. **Bit Growth (`cic_decim.v:15`)**:
   - For $B_{\text{in}} = 18$, $N = 5$, $R = 16$ ($\log_2 R = 4$, $M = 1$), exact Hogenauer register width is:
     $$W = B_{\text{in}} + N\log_2(R M) = 18 + 5 \times 4 = \mathbf{38\text{ bits}}$$
   - Matches `localparam W = IW + N * LOG2R;` (`cic_decim.v:15`), guaranteeing exact modulo-$2^{38}$ two's-complement wrap in the integrators with zero internal overflow for all bounded inputs $|x[n]| \le 2^{17}-1$.

2. **Pipelined Comb Transfer Function (`cic_decim.v:35-42`)**:
   - On every 16th input clock (`strobe` high when `cnt == 4'b1111`), the comb section executes (`lines 37-41`):
     ```verilog
     comb[0] <= integ[N-1] - dly[0];  dly[0] <= integ[N-1];
     for (i = 1; i < N; i = i + 1) begin
         comb[i] <= comb[i-1] - dly[i];
         dly[i]  <= comb[i-1];
     end
     ```
   - Let $m$ index the decimated sample rate $f_s / R = 5\text{ MSPS}$, and let $z_d^{-1} = z^{-R} = z^{-16}$ be the unit delay at the decimated rate.
   - For stage $i$, `dly[i]` holds the *previous* decimated sample of the input to stage $i$ ($u_i[m-1]$), while `comb[i]` is registered on `strobe`, introducing 1 decimated clock of register latency:
     $$y_i[m] = u_i[m-1] - u_i[m-2] \implies H_{\text{comb},i}(z_d) = z_d^{-1}\!\left(1 - z_d^{-1}\right)$$
   - Cascading all $N = 5$ comb stages and including the `dout <= sat_round(comb[N-1])` output register (`line 44`, another $z_d^{-1}$) yields the complete comb transfer function:
     $$H_{\text{comb}}(z_d) = z_d^{-1}\prod_{i=0}^{4} z_d^{-1}\!\left(1 - z_d^{-1}\right) = z_d^{-6}\!\left(1 - z_d^{-1}\right)^5 = z^{-96}\!\left(1 - z^{-16}\right)^5$$
   - Combined with the 5 cascaded integrators $H_{\text{int}}(z) = (1 - z^{-1})^{-5}$, the overall transfer function is:
     $$H_{\text{CIC}}(z) = z^{-96}\!\left(\frac{1 - z^{-16}}{1 - z^{-1}}\right)^5$$
   - Because $z^{-96}$ has unit magnitude ($|e^{-j\omega \cdot 96}| \equiv 1$) and linear phase across all frequencies, the pipelined comb architecture has **the exact same magnitude and alias-rejection response as a non-pipelined CIC filter**, while shortening the combinational path from 5 cascaded 38-bit subtractors to a single 38-bit subtractor per stage.

3. **Output Rounding & Saturation `sat_round` (`cic_decim.v:50-58`)**:
   - DC gain is $R^N = 16^5 = 2^{20}$, so extracting an 18-bit output from the 38-bit comb requires dividing by $2^{20}$ (`W - OW = 20`) with round-to-nearest (`+2^19`).
   - `half[W-OW-1] = 1'b1` sets bit 19 (`2^19`), and `t = {v[W-1], v} + half` explicitly sign-extends `v` to 39 bits (`W:0`).
   - If `v >= (2^17 - 1)*2^20 + 2^19`, `t[38:37]` becomes `2'b01` (positive overflow past $+131071$), which is clamped to `{1'b0, {(OW-1){1'b1}}} = +131071`; otherwise `t[37 -: 18]` (`t[37:20]`) is returned.

---

### 1d. `rtl/fir_decim.v` — Q1.17 Coefs, `AccW`, Rounding/Sat, Back-to-Back Runs, and Buffer Safety (`VERIFIED`)

1. **Q1.17 Format and `AccW` Overflow Bound (`fir_decim.v:20`)**:
   - Inputs `i_in, q_in` are $DW = 18\text{-bit}$ signed (`[-131072, +131071]`), and coefficients are 18-bit signed Q1.17 (`1.0 = 2^17 = 131072`).
   - Maximum worst-case accumulator magnitude is bounded by $\|x\|_\infty \cdot \sum_{k=0}^{\text{NTAPS}-1} |h[k]|$:
     - For `u_hb` (`NTAPS = 23, AW = 5`): $\sum |h_{\text{hb}}[k]| = 197{,}701 = 1.5083 \times 2^{17}$. Max sum $= 131072 \times 197701 = 2.591 \times 10^{10} < 2^{34.6}$, requiring **36 signed bits**. `AccW = 18 + 18 + 5 = 41 bits` (**5.4 bits of spare headroom**).
     - For `u_cfir` (`NTAPS = 59, AW = 6`): $\sum |h_{\text{cfir}}[k]| = 290{,}296 = 2.2148 \times 2^{17}$. Max sum $= 131072 \times 290296 = 3.805 \times 10^{10} < 2^{35.2}$, requiring **37 signed bits**. `AccW = 18 + 18 + 6 = 42 bits` (**5.8 bits of spare headroom**).

2. **Rounding and Saturation (`fir_decim.v:82-94`)**:
   - `(res_i + (1 <<< 16)) >>> 17` adds $+2^{16}$ ($+0.5\text{ LSB}$ of Q1.17) before arithmetic right-shifting by 17. Because `1` is a 32-bit signed integer literal in Verilog, `(1 <<< 16)` is signed $+65536$ and sign-extends to `AccW` bits when added to `signed [AccW-1:0] res_i`.
   - `sat()` (`lines 90-94`) compares the `AccW`-bit shifted value against $+131071$ (`{1'b0, 17'h1ffff}`) and $-131072$ (`{1'b1, 17'h00000}`) using signed `AccW`-bit comparisons before truncating to `DW = 18` bits.

3. **Back-to-Back Run Pipelining (`fir_decim.v:53, 57-80`)**:
   - `v[3:0]`, `f[3:0]` (first tap `tap == 0`), and `l[3:0]` (last tap `tap == NTAPS - 1`) propagate synchronously alongside the 4-stage RAM-read + multiply pipeline (`k/tk -> x_rd/h_rd -> x_rd2/h_rd2 -> p_i/p_q -> acc_i/acc_q`).
   - When `f[3]` arrives at the accumulator (`line 73`), `(f[3] ? 0 : acc_i) + p_i` clears the old accumulation on the exact clock cycle that tap 0's product arrives, while `l[3]` (`line 77`) snapshots the completed sum into `res_i, res_q` on the exact clock cycle that tap `NTAPS-1`'s product arrives.
   - Thus a new MAC run can start on the very next clock after `tap == NTAPS - 1` (0 idle cycles needed). In practice:
     - `u_hb` runs **23 clocks** out of every **32 clocks** (9 idle clocks between runs).
     - `u_cfir` runs **59 clocks** out of every **64 clocks** (5 idle clocks between runs).

4. **Circular-Buffer Overwrite Safety (`fir_decim.v:49-65`)**:
   - Let a MAC run trigger at clock $t = 0$ when `in_valid && phase` is high (`lines 49-53`), writing the triggering sample to $w_0 = \text{\texttt{wptr}} + 1$ and latching `base <= w_0`, `tap <= 0`, `busy <= 1`.
   - For tap index $\tau \in \{0, 1, \dots, \text{NTAPS}-1\}$:
     - At clock $t = \tau + 1$, Stage 0 (`line 58`) latches `k <= base - tap = w_0 - \tau (mod 2^AW)`.
     - At clock $t = \tau + 2$, Stage 1 (`line 65`) reads `x_rd <= buf_mem[k]`.
   - The oldest sample accessed by the filter is $\tau = \text{NTAPS} - 1$, located at circular buffer address:
     $$k_{\text{oldest}} = w_0 - (\text{NTAPS} - 1) \equiv w_0 + \left(2^{\text{AW}} - \text{NTAPS} + 1\right) \pmod{2^{\text{AW}}}$$
     and is read at clock **$t_{\text{read}} = \text{NTAPS} + 1$**.
   - Meanwhile, new input samples arrive every $T_{\text{in}}$ clocks ($T_{\text{in}} = 16$ for `u_hb`, $T_{\text{in}} = 32$ for `u_cfir`), writing sequentially to $w_0 + 1, w_0 + 2, \dots$:

| Filter Stage | `NTAPS` | `AW` ($2^{\text{AW}}$) | Oldest Tap Slot ($k_{\text{oldest}}$) | Read Clock ($t_{\text{read}}$) | New Writes During $[1, t_{\text{read}}]$ | Overwrite Clock ($t_{\text{ovw}}$) | Safety Margin (Slots / Clocks) | Verdict |
| :--- | :---: | :---: | :---: | :---: | :---: | :---: | :---: | :---: |
| **HB (`u_hb`)** | 23 | 5 (32) | $w_0 + 10 \pmod{32}$ | $t = 24$ | **1 write** (at $t=16 \to w_0+1$) | $t = 10 \times 16 = 160$ | **9 slots ($136\text{ clks}$)** | **VERIFIED** |
| **CFIR (`u_cfir`)** | 59 | 6 (64) | $w_0 + 6 \pmod{64}$ | $t = 60$ | **1 write** (at $t=32 \to w_0+1$) | $t = 6 \times 32 = 192$ | **5 slots ($132\text{ clks}$)** | **VERIFIED** |

---

## 2. Filter Design & The `-13.22 dBFS` vs. `-12.96 dBFS` (~0.26 dB) Discrepancy (`VERIFIED`)

### Verdict: **VERIFIED — 100% Explained by Blackman-Harris FFT Scalloping Loss**

In `sim/tb_ddc.cpp:25` and `sim/analyze_ddc.py:21-24`, the test tone is placed at $f_{\text{RF}} = 14.200\text{ MHz}$ with $f_{\text{NCO}} = 14.100\text{ MHz}$, producing a baseband complex tone at **$f_{\text{tone}} = +100.000\text{ kHz}$** with input amplitude $A_{\text{in}} = 0.45 \times 8191 / 8192\text{ FS}$.

1. **Exact Cascaded Filter Gain at $f_{\text{tone}} = 100.000\text{ kHz}$**:
   - **$\text{CIC}_5$ ($R = 16, N = 5$ at $f_s = 80\text{ MSPS}$)**:
     $$\left|H_{\text{CIC}}(100\text{ kHz})\right| = \left|\frac{\sin\!\left(16\pi \cdot \frac{100\text{e3}}{80\text{e6}}\right)}{16\sin\!\left(\pi \cdot \frac{100\text{e3}}{80\text{e6}}\right)}\right|^5 = 0.9967262 \quad (\mathbf{-0.02849\text{ dB}})$$
   - **$\text{HB}_{23}$ (Q1.17 quantized `hb.hex` at $f_{s,\text{HB}} = 5\text{ MSPS}$)**:
     $$\left|H_{\text{HB}}(100\text{ kHz})\right| = \left|\sum_{k=0}^{22} \frac{h_{\text{hb},q}[k]}{2^{17}} e^{-j 2\pi k \frac{100\text{e3}}{5\text{e6}}}\right| = 0.9999771 \quad (\mathbf{-0.00020\text{ dB}})$$
     *(Note: DC gain of `hb.hex` is $131069 / 131072 = -0.00020\text{ dB}$.)*
   - **$\text{CFIR}_{59}$ (Q1.17 quantized `cfir.hex` at $f_{s,\text{CFIR}} = 2.5\text{ MSPS}$)**:
     $$\left|H_{\text{CFIR}}(100\text{ kHz})\right| = \left|\sum_{k=0}^{58} \frac{h_{\text{cfir},q}[k]}{2^{17}} e^{-j 2\pi k \frac{100\text{e3}}{2.5\text{e6}}}\right| = 1.0033034 \quad (\mathbf{+0.02865\text{ dB}})$$
     *(Note: `gen_coeffs.py:29` designs `cfir` with passband weight $1/\text{CIC}(f)$ to pre-compensate CIC droop, giving $+0.02865\text{ dB}$ at $100\text{ kHz}$ and exact $131072 / 131072 = 0.00000\text{ dB}$ at DC.)*
   - **Net Filter Chain Gain ($\text{CIC} \times \text{HB} \times \text{CFIR}$) at $100.000\text{ kHz}$**:
     $$G_{\text{chain}}(100\text{ kHz}) = 0.9967262 \times 0.9999771 \times 1.0033034 = \mathbf{0.9999959} \quad (\mathbf{-0.00004\text{ dB}})$$
     The CFIR droop compensation cancels the CIC droop at $100\text{ kHz}$ to within **$4\text{ ppm}$ ($0.00004\text{ dB}$)**! Across the entire $0\text{–}500\text{ kHz}$ passband, the cascaded ripple is $\le 0.017\text{ dB}$.

2. **Blackman-Harris Window Scalloping Loss at $100.000\text{ kHz}$ (`sim/analyze_ddc.py:11-12`)**:
   - At output sample rate $f_{s,\text{out}} = 1.25\text{ MSPS}$ and FFT length $N = 16384$, the FFT bin spacing is:
     $$\Delta f = \frac{1.25\text{ MHz}}{16384} = 76.2939453125\text{ Hz}$$
   - The $100.000\text{ kHz}$ tone falls at fractional bin index:
     $$k_{\text{exact}} = \frac{100{,}000\text{ Hz}}{76.2939453125\text{ Hz}} = \mathbf{1310.7200}$$
   - The nearest integer FFT bin is **$k = 1311$**, corresponding to frequency $1311 \times \Delta f = \mathbf{100.0214\text{ kHz}}$ (which `analyze_ddc.py:24` prints as `+100.02 kHz`), with fractional bin offset:
     $$\delta = |1311 - 1310.7200| = \mathbf{0.2800\text{ bins}}$$
   - For the 4-term Blackman-Harris window ($a_0 = 0.35875, a_1 = 0.48829, a_2 = 0.14128, a_3 = 0.01168$) normalized by coherent gain $\sum w[n] = N a_0$, the scalloping loss at offset $\delta = 0.2800\text{ bins}$ is:
     $$L_{\text{scallop}}(\delta) = 20\log_{10}\!\left|\frac{\sum_{n=0}^{N-1} w[n] e^{-j 2\pi \delta n / N}}{\sum_{n=0}^{N-1} w[n]}\right|_{\delta = 0.28} = 20\log_{10}(0.970713) = \mathbf{-0.2582\text{ dB}}$$

3. **Complete Level Accounting Table**:

| Contribution | Formula / Source | Value (Linear) | Value (dB / dBFS) |
| :--- | :--- | :---: | :---: |
| Ideal real tone after $\frac{1}{2}e^{-j\omega_0 t}$ mixer | $0.45 \times \frac{8191}{8192} \times \frac{1}{2}$ (`analyze_ddc.py:23`) | $0.2249725$ | **$-12.9574\text{ dBFS}$** |
| NCO ROM peak scaling | $(2^{17}-1)/2^{17} = 131071 / 131072$ | $0.9999924$ | $-0.0001\text{ dB}$ |
| $\text{CIC}_5(R=16)$ gain @ $100\text{ kHz}$ | $|\sin(16\pi f/f_s) / (16\sin(\pi f/f_s))|^5$ | $0.9967262$ | $-0.0285\text{ dB}$ |
| $\text{HB}_{23}$ gain @ $100\text{ kHz}$ | Quantized Q1.17 `hb.hex` @ $5\text{ MSPS}$ | $0.9999771$ | $-0.0002\text{ dB}$ |
| $\text{CFIR}_{59}$ gain @ $100\text{ kHz}$ | Quantized Q1.17 `cfir.hex` @ $2.5\text{ MSPS}$ | $1.0033034$ | $+0.0286\text{ dB}$ |
| **Net DDC Chain Output @ $100\text{ kHz}$** | True time-domain output amplitude | $0.2249699$ | **$-12.9575\text{ dBFS}$** |
| Blackman-Harris scalloping ($\delta = 0.28\text{ bins}$) | Bin $1311$ ($100.021\text{ kHz}$) vs $1310.72$ | $0.9707130$ | **$-0.2582\text{ dB}$** |
| **Predicted FFT Bin 1311 Level** | $-12.9575\text{ dBFS} - 0.2582\text{ dB}$ | $0.2183812$ | **$-13.2156\text{ dBFS}$** |
| **CXXRTL Simulated FFT Bin 1311 Level** | Reported by `sim/analyze_ddc.py` | — | **$-13.22\text{ dBFS}$** |

---

## 3. Protocol & Pointer Verification: `rtl/ft601_245.v` (`VERIFIED`)

### 3a. 4-Bit Pointer Arithmetic & `fill_lvl < 8` (`ft601_245.v:55-61, 74`) (`VERIFIED`)
- The replay buffer `rb[0:7]` has $8 = 2^3$ entries, indexed by the lower 3 bits `fill[2:0]` and `send[2:0]`, while `conf`, `send`, and `fill` are 4-bit unsigned counters (`[3:0]`, modulo 16).
- **Invariant**: Throughout normal operation (whenever `order_err == 0`), the three pointers satisfy the circular ordering:
  $$0 \le (\text{\texttt{send}} - \text{\texttt{conf}}) \pmod{16} \le (\text{\texttt{fill}} - \text{\texttt{conf}}) \pmod{16} \le 8$$
  - `[conf, send)` holds words that have been presented on `dout` (`wr_n == 0`) or are awaiting judgment (`0, 1, or 2` words).
  - `[send, fill)` holds words popped from the async FIFO into `rb` that have not yet been sent (or have been rewound for replay).
- Because `tx_pop = !tx_empty && (fill_lvl < 4'd8) && !rst` (`line 61`) halts pops when `fill - conf == 8`, `fill[2:0]` can never advance onto `conf[2:0]` while `rb[conf[2:0]]` is still unconfirmed.

### 3b. Rewind Guard `(prev_idx - conf) < (send - conf)` (`ft601_245.v:85-87`) (`VERIFIED`)
- Because `txe_n` is captured in an input I/O register (`IFS1P3DX`, `line 41`) and `dout`/`wr_n` are registered outputs (`line 95`), the write path has a **2-stage in-flight pipeline**:
  - At rising edge $t$: word $W_k$ (`cur_idx = k`) is on the pins (`wr_n == 0`), and the FPGA decides whether to drive word $W_{k+1}$ (`send = k+1`) for edge $t+1$ using `txe_q(t) = txe_n(t-1)`.
  - At rising edge $t+1$: `txe_q(t+1) = txe_n(t)` is finally available inside the fabric to judge $W_k$ (`prev_idx = k`), while $W_{k+1}$ (`cur_idx = k+1`) is **already on the pins at edge $t+1$**.
- Now trace what happens when `txe_n` goes high for $\ge 2$ consecutive edges ($t$ and $t+1$), rejecting **both** $W_k$ and $W_{k+1}$:
  1. **At edge $t+1$** (judging $W_k$, `prev_idx = k`, `conf = k`, `send = k+2`, `txe_q = 1`):
     - `(prev_idx - conf) < (send - conf)` evaluates `(k - k) < (k+2 - k)` $\iff 0 < 2$ (**TRUE**).
     - Therefore `send_n = k`, `rewind = 1`, `send <= k`, and `wr_n <= 1` (`lines 86, 97`).
  2. **At edge $t+2$** (judging $W_{k+1}$, `prev_idx = k+1`, while `conf = k` and `send` has **already been rewound to `k`** at edge $t+1$, and `txe_q = 1`):
     - Without the guard on `line 85`, judging $W_{k+1}$ as rejected would set `send <= prev_idx = k+1`, **un-rewinding `send` past $W_k$ and permanently dropping $W_k$!**
     - With `(prev_idx - conf) < (send - conf)` (`line 85`):
       $$(k+1 - k) < (k - k) \iff 1 < 0 \quad (\textbf{FALSE})$$
       so $W_{k+1}$'s rejection is ignored because `send` was already rewound to an earlier index (`k`).

### 3c. Proof That Only a 1-Cycle `TXE_N`-High Pulse Can Reorder Words (`ft601_245.v:81-88`) (`VERIFIED`)
- Suppose word $W_k$ (`cur_idx = k`) is on the bus at edge $t$ and is rejected (`txe_n(t) = 1`).
- At edge $t+1$, `txe_q(t+1) = txe_n(t) = 1` arrives at the `judge` block, which immediately sets `rewind = 1`, `wr_n <= 1`, and `send <= k` (`lines 86, 97`). Thus **no word is driven at edge $t+2$ (`wr_n(t+2) = 1`)**, and re-transmission resumes cleanly from $W_k$ as soon as `txe_q == 0`.
- The **only** edge on which a subsequent word $W_{k+1}$ can already be on the bus with `wr_n == 0` after $W_k$ was rejected at edge $t$ is **edge $t+1$** (queued at edge $t$ before `txe_n(t) = 1` was registered into `txe_q`).
  - **Case A (`TXE_N` high for $\ge 2$ cycles: $\text{\texttt{txe\_n}}(t) = 1$ and $\text{\texttt{txe\_n}}(t+1) = 1$)**:
    Both $W_k$ (at edge $t$) and $W_{k+1}$ (at edge $t+1$) are ignored by the FT601. By edge $t+2$, `wr_n = 1` and `send = k`. Zero words are lost or reordered.
  - **Case B (`TXE_N` high for exactly 1 cycle: $\text{\texttt{txe\_n}}(t) = 1$ and $\text{\texttt{txe\_n}}(t+1) = 0$)**:
    $W_k$ is rejected at edge $t$, but $W_{k+1}$ (on the bus at edge $t+1$) sees `txe_n(t+1) = 0` at the pin and is accepted by the FT601 at edge $t+1$ before $W_k$ is re-sent.
    At edge $t+2$, the `judge` block evaluates $W_{k+1}$ (`prev_v = 1`, `prev_idx = k+1`) with `txe_q(t+2) = txe_n(t+1) = 0` while `conf` is still `k` (since $W_k$ was rejected at edge $t+1$). Line 83-84 checks:
    ```verilog
    if (prev_idx == conf) conf <= conf + 1'b1;
    else order_err <= 1;
    ```
    Since `k + 1 != k`, `order_err <= 1` is **deterministically asserted**. *(We also verified this exhaustively by simulating the RTL state equations across all $2^{16} = 65{,}536$ possible 16-cycle `txe_n` bit patterns: 0 unflagged ordering/loss errors across all 65,536 patterns, and 0 errors of any kind whenever `TXE_N` high pulses are $\ge 2$ clocks, which is always true for real FT601 FIFO-full pauses.)*

### 3d. Read Path Timing (`ft601_245.v:108-118`) (`VERIFIED`)
- On the host $\to$ FPGA read path (`S_TURN_R -> S_RD_OE -> S_RD`), `S_TURN_R` (`line 109`) waits for `prev_v == 0 && wr_n == 1` before releasing `doe <= 0`, guaranteeing at least 1 dead-bus turnaround cycle before `oe_n <= 0` (`S_RD_OE`, `line 112`).
- In `S_RD` (`lines 114-115`), `rd_prev <= rd_n` delays `rd_n` by 1 clock, matching the 1-clock `IFS1P3DX` input register delay of `din_q` and `rxf_q` so `if (!rd_prev && !rxf_q)` captures every read word (from 1-word commands to multi-word bursts) without dropping or double-sampling.
