cfbird/usb3-sdr/notes/fanout/agy_plan.png

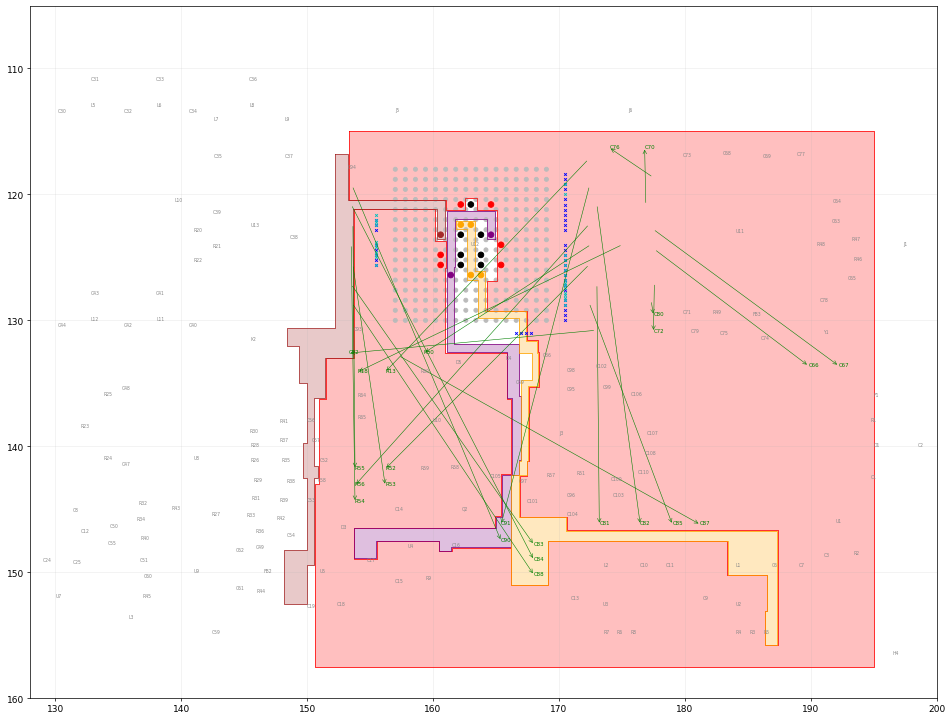
notes/fanout/agy_plan.png
