cfbird/usb3-sdr/notes/fanout/fanout_now.png

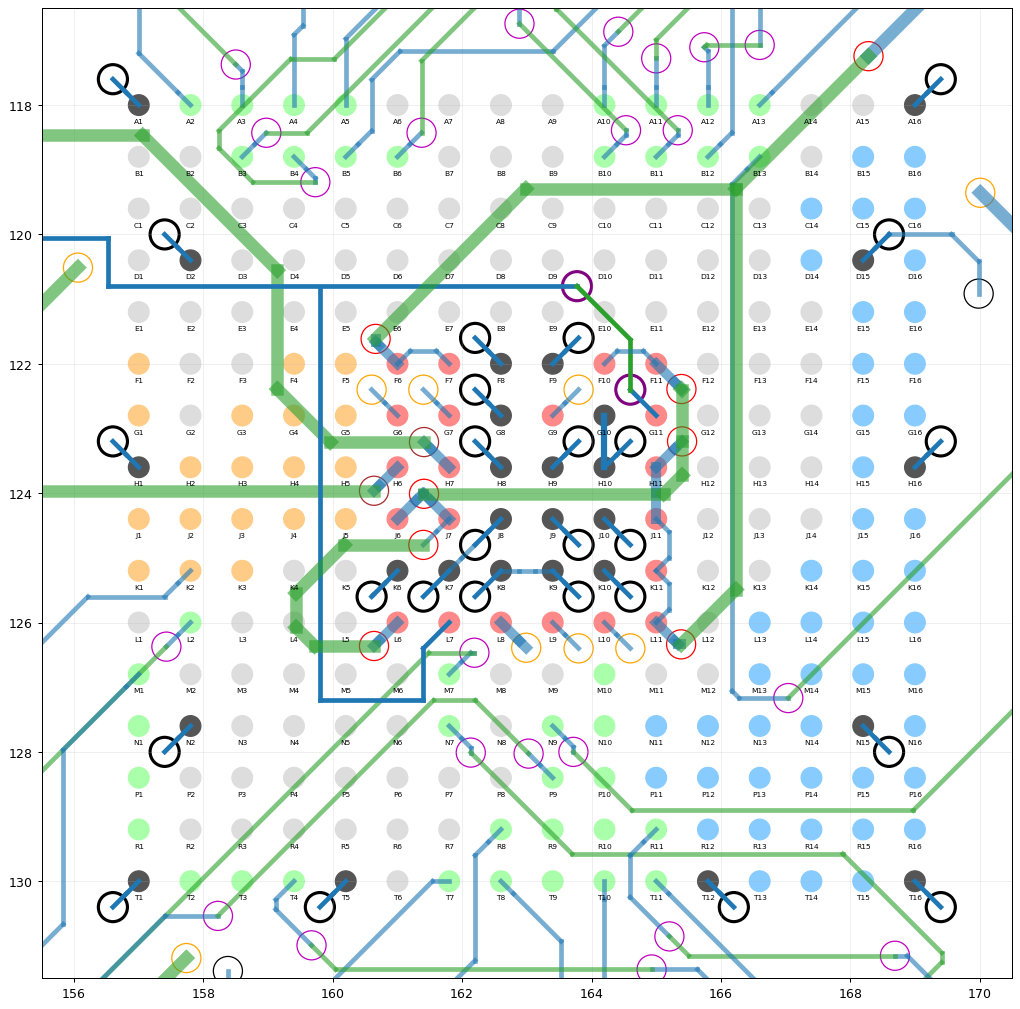
notes/fanout/fanout_now.png
