cfbird/usb3-sdr/notes/u11/ftopen_r4.png

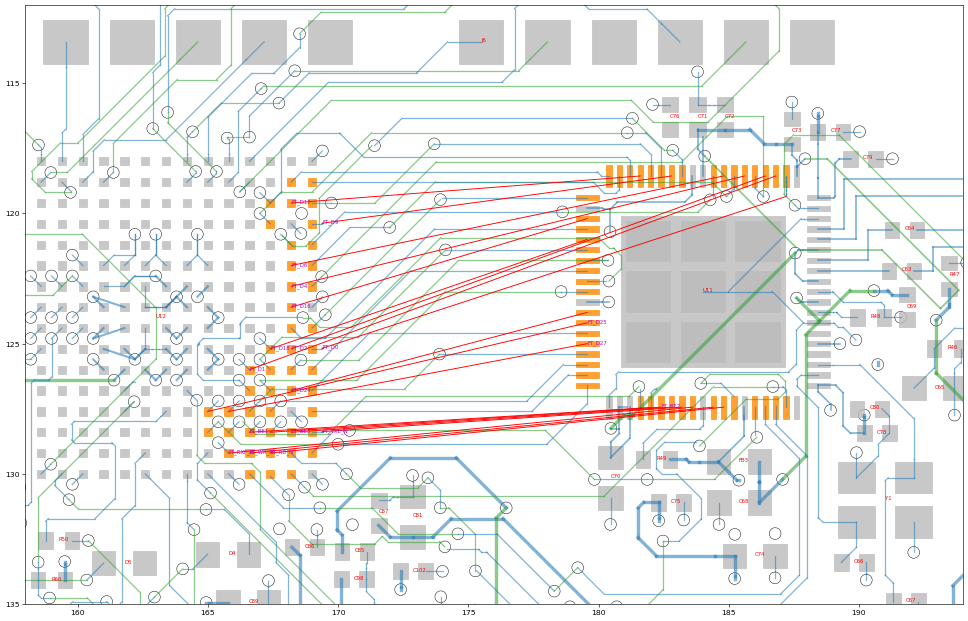
notes/u11/ftopen_r4.png
