cfbird/usb3-sdr/refs/renders/pcb3d.png

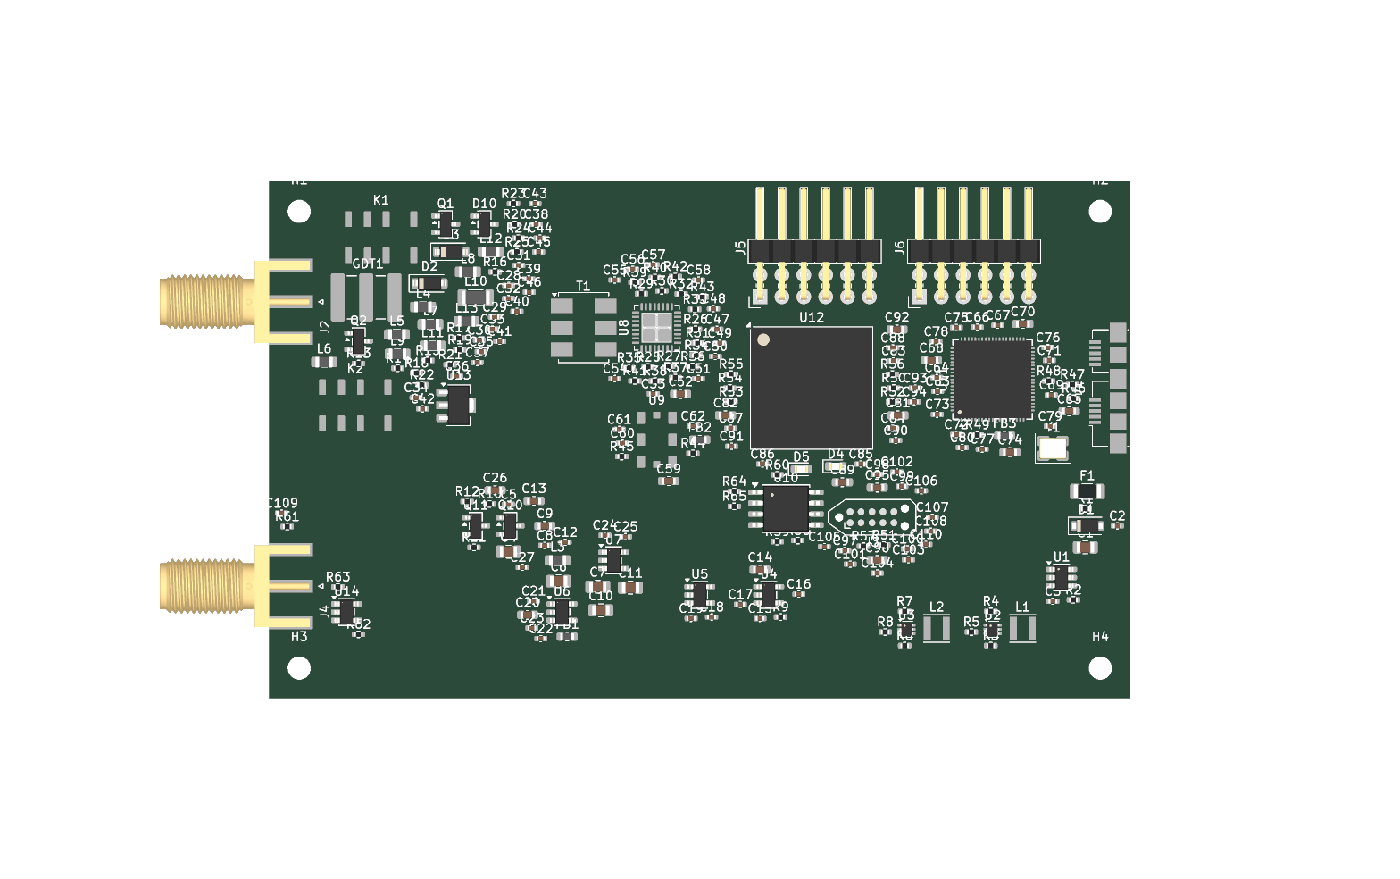
refs/renders/pcb3d.png
