cfbird/usb3-sdr/refs/renders/rf_crop.png

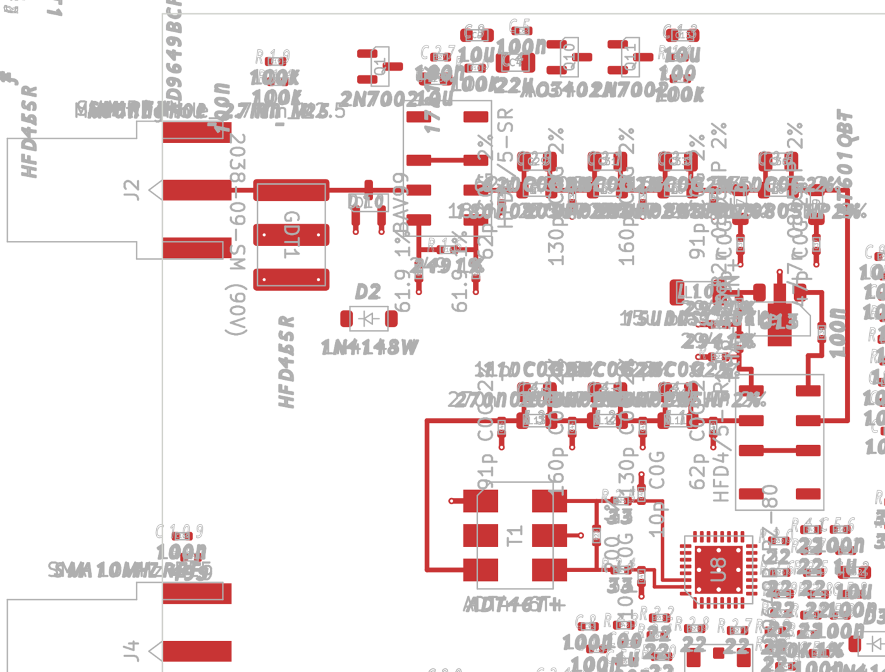
refs/renders/rf_crop.png
