cfbird/usb3-sdr/refs/renders/sch-1.png

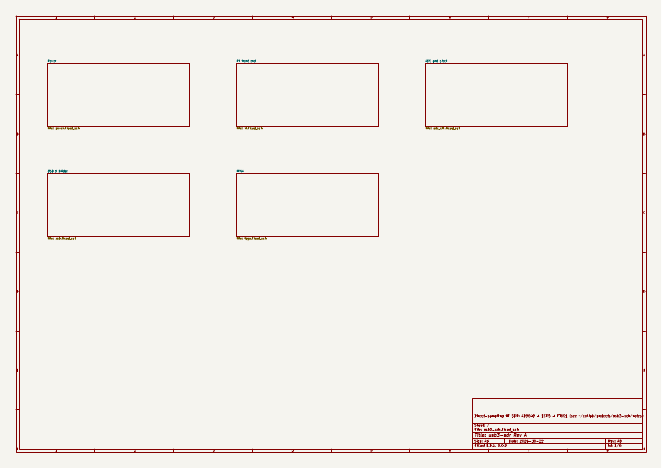
refs/renders/sch-1.png
