cfbird/usb3-sdr/refs/renders/sch-2.png

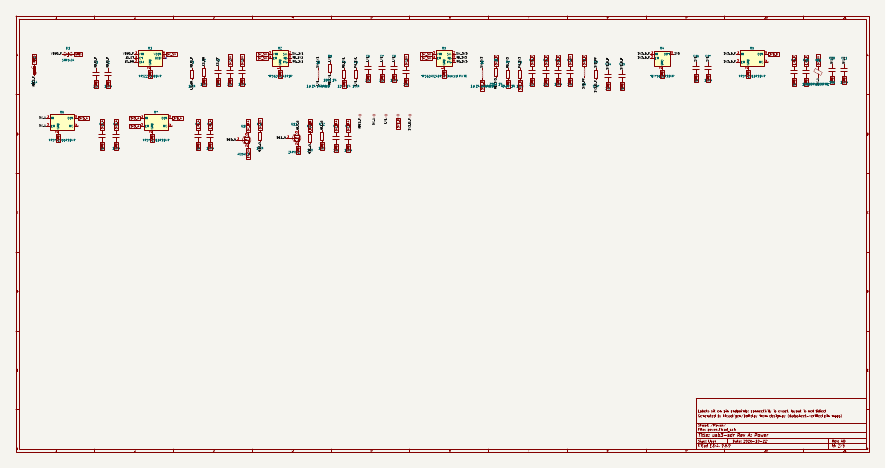
refs/renders/sch-2.png
