cfbird/usb3-sdr/refs/renders/sch-3.png

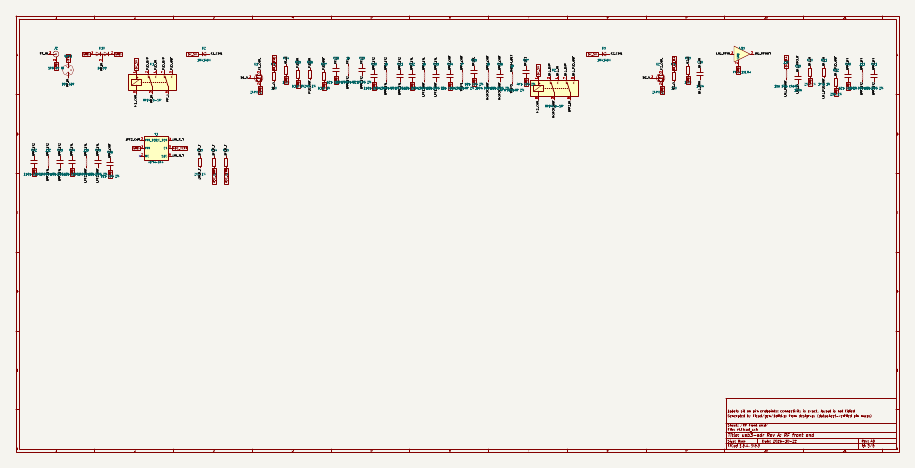
refs/renders/sch-3.png
