cfbird/usb3-sdr/refs/renders/sch-4.png

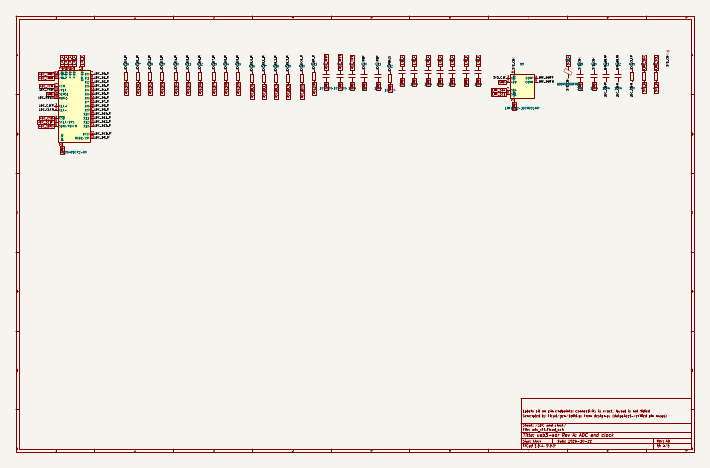
refs/renders/sch-4.png
