cfbird/usb3-sdr/refs/renders/sch-5.png

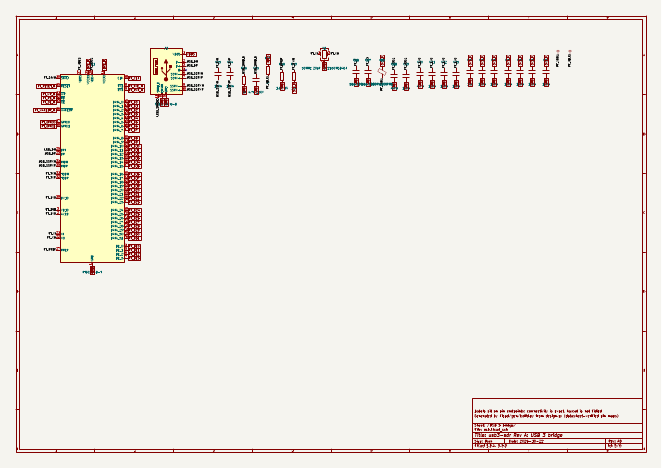
refs/renders/sch-5.png
