cfbird/usb3-sdr/refs/renders/sch-6.png

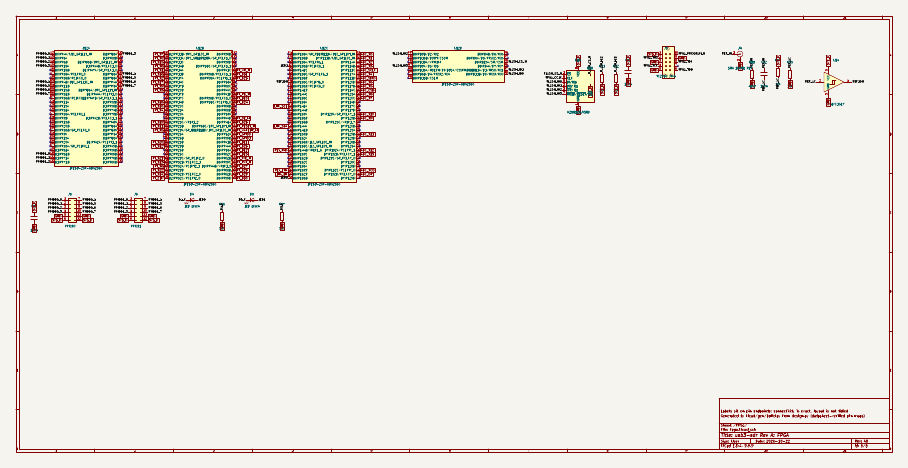
refs/renders/sch-6.png
