cfbird/usb3-sdr/kicad/usb3-sdr.pdf

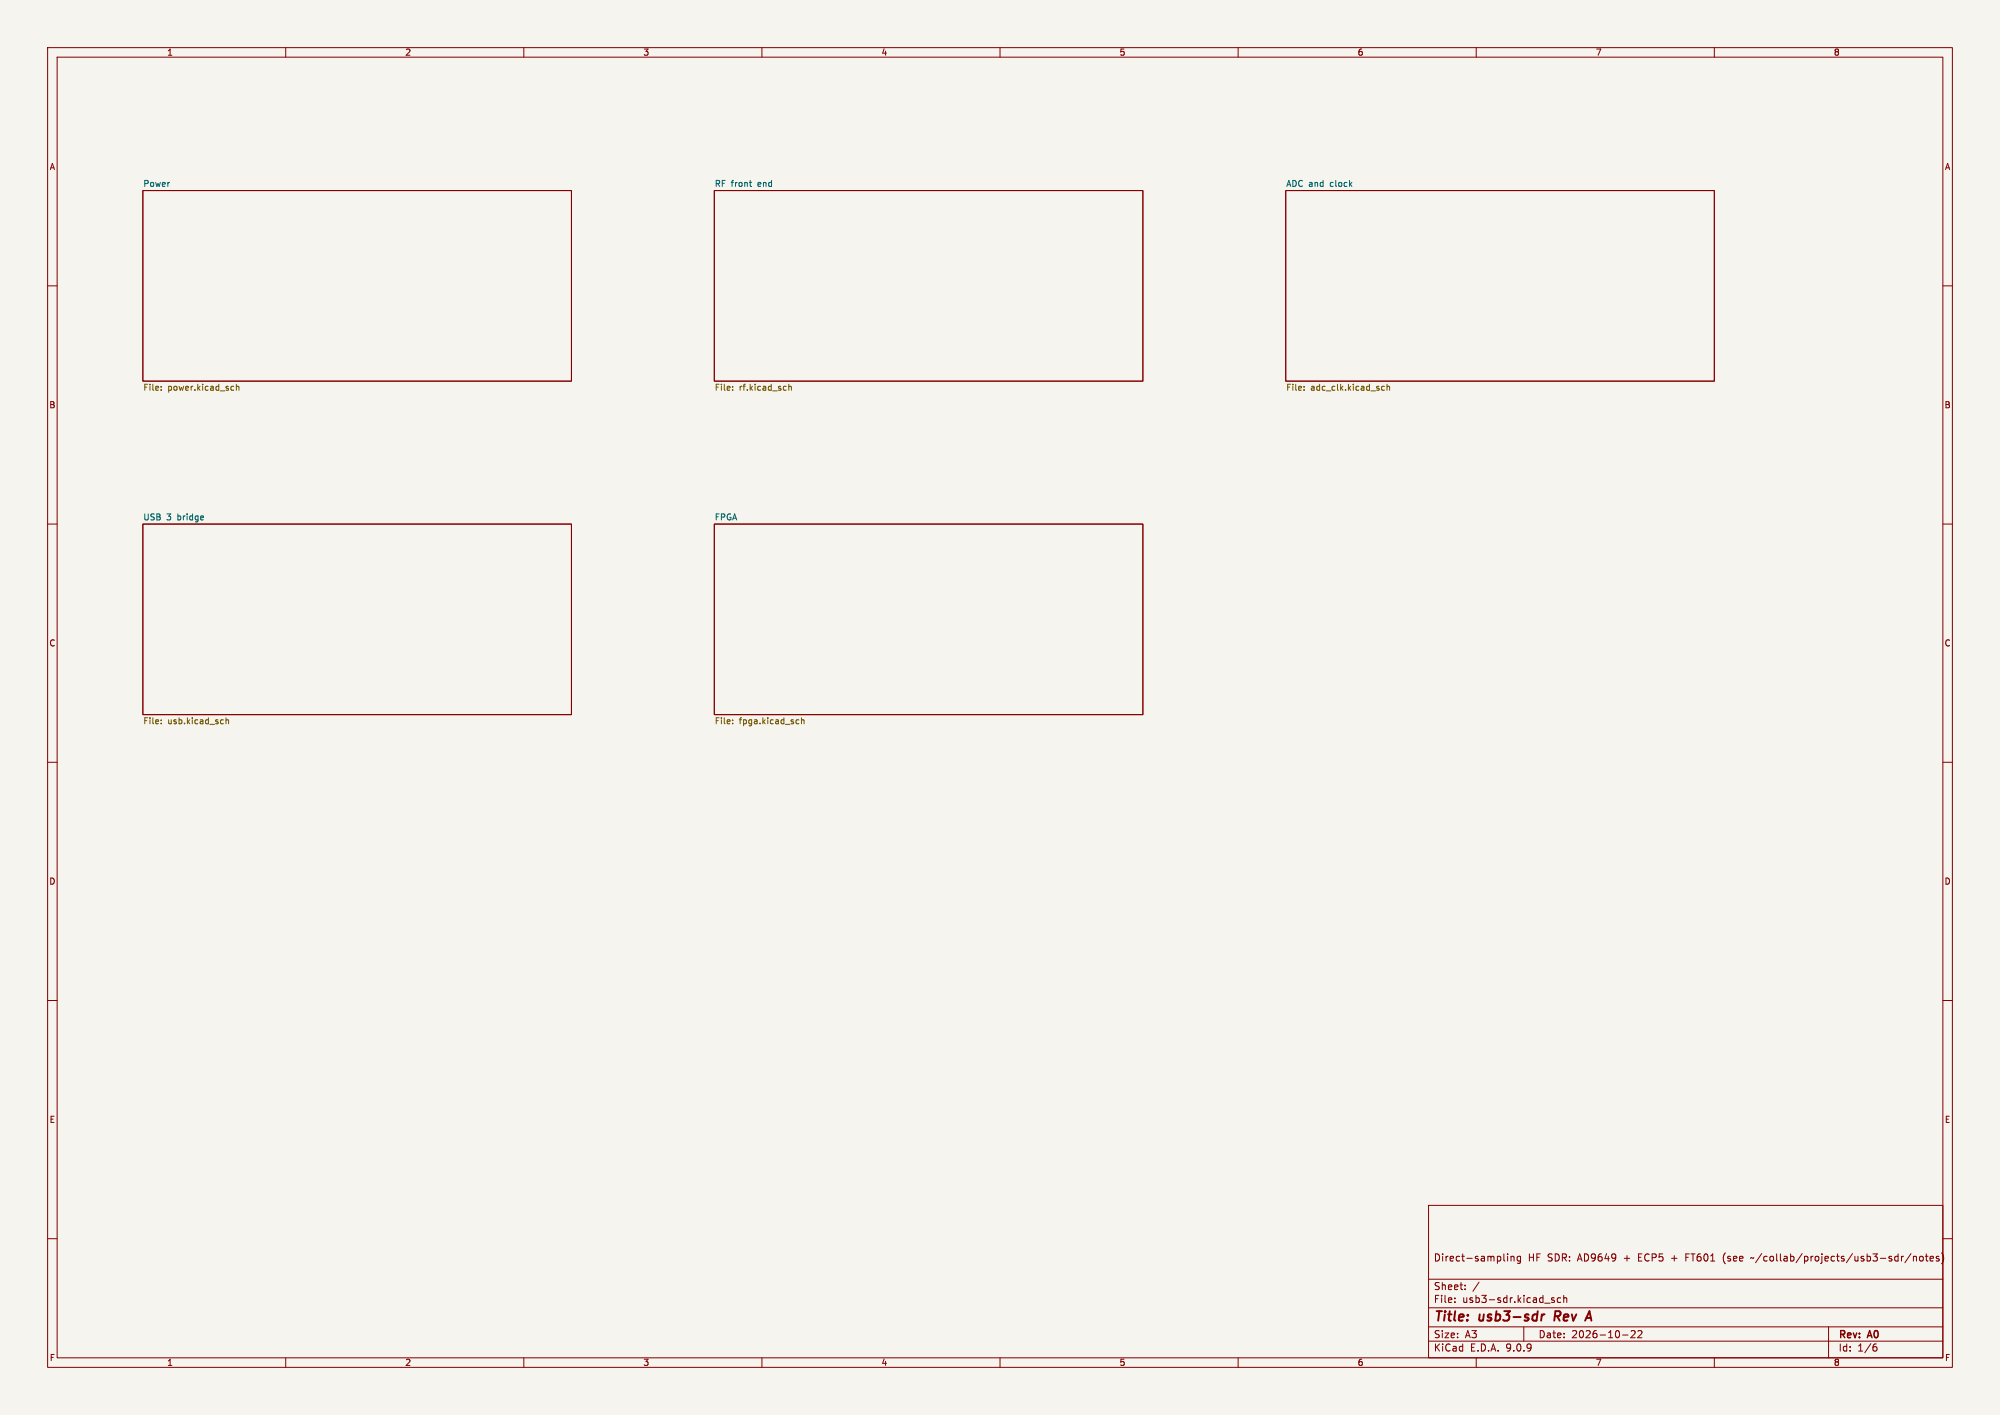
[picture p13: page 1]

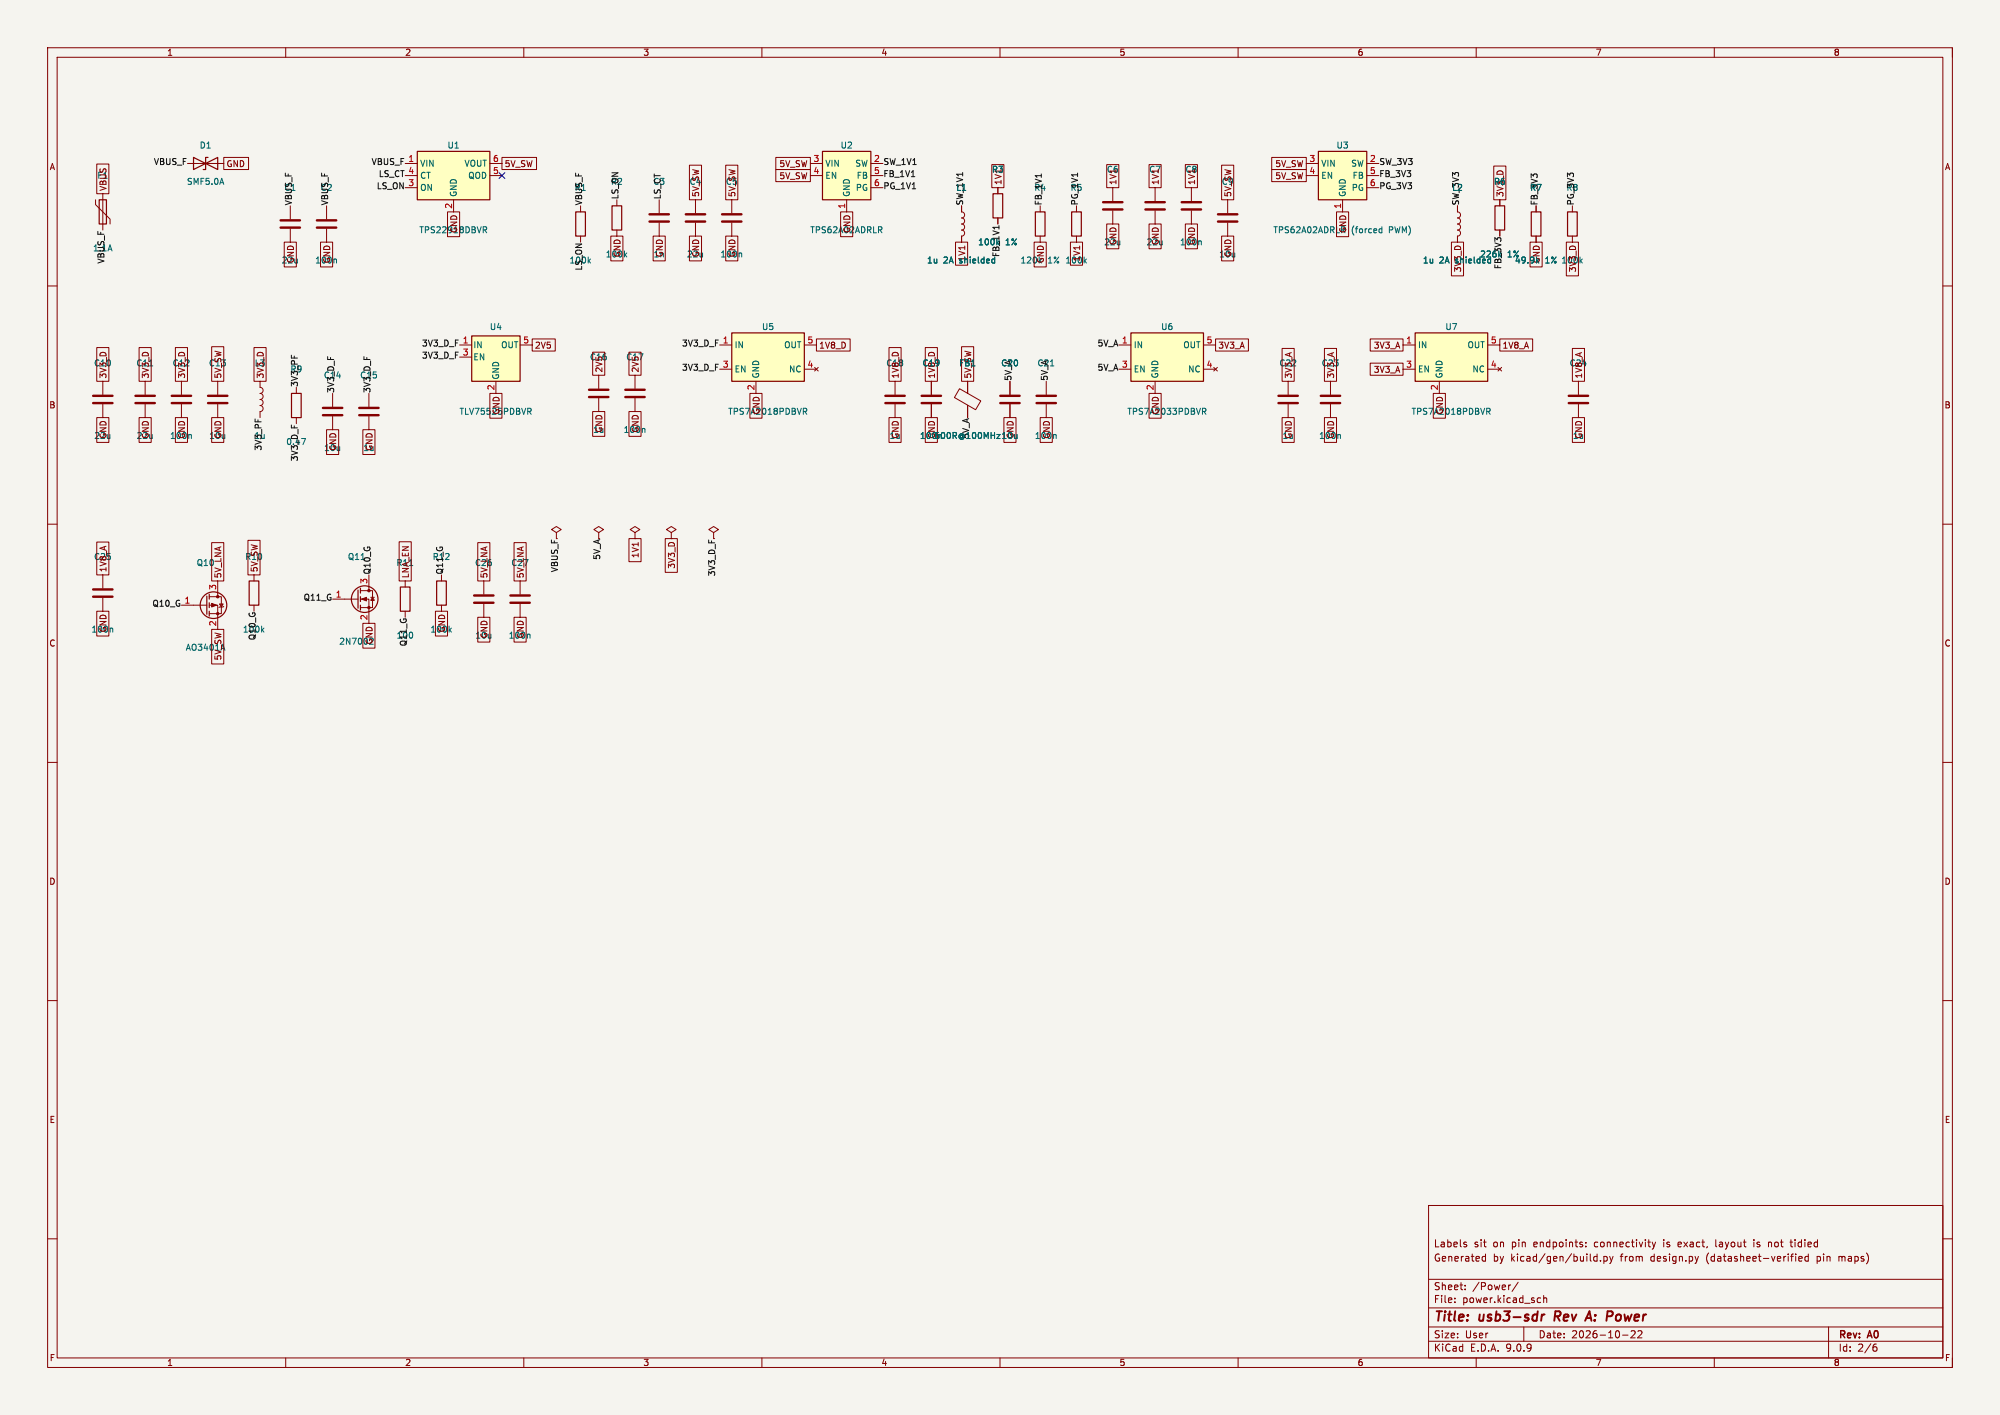
[picture p14: page 2]

1 SW 2 FB 5 PG 6 U3 TPS62A02ADRLR (forced PWM) C24

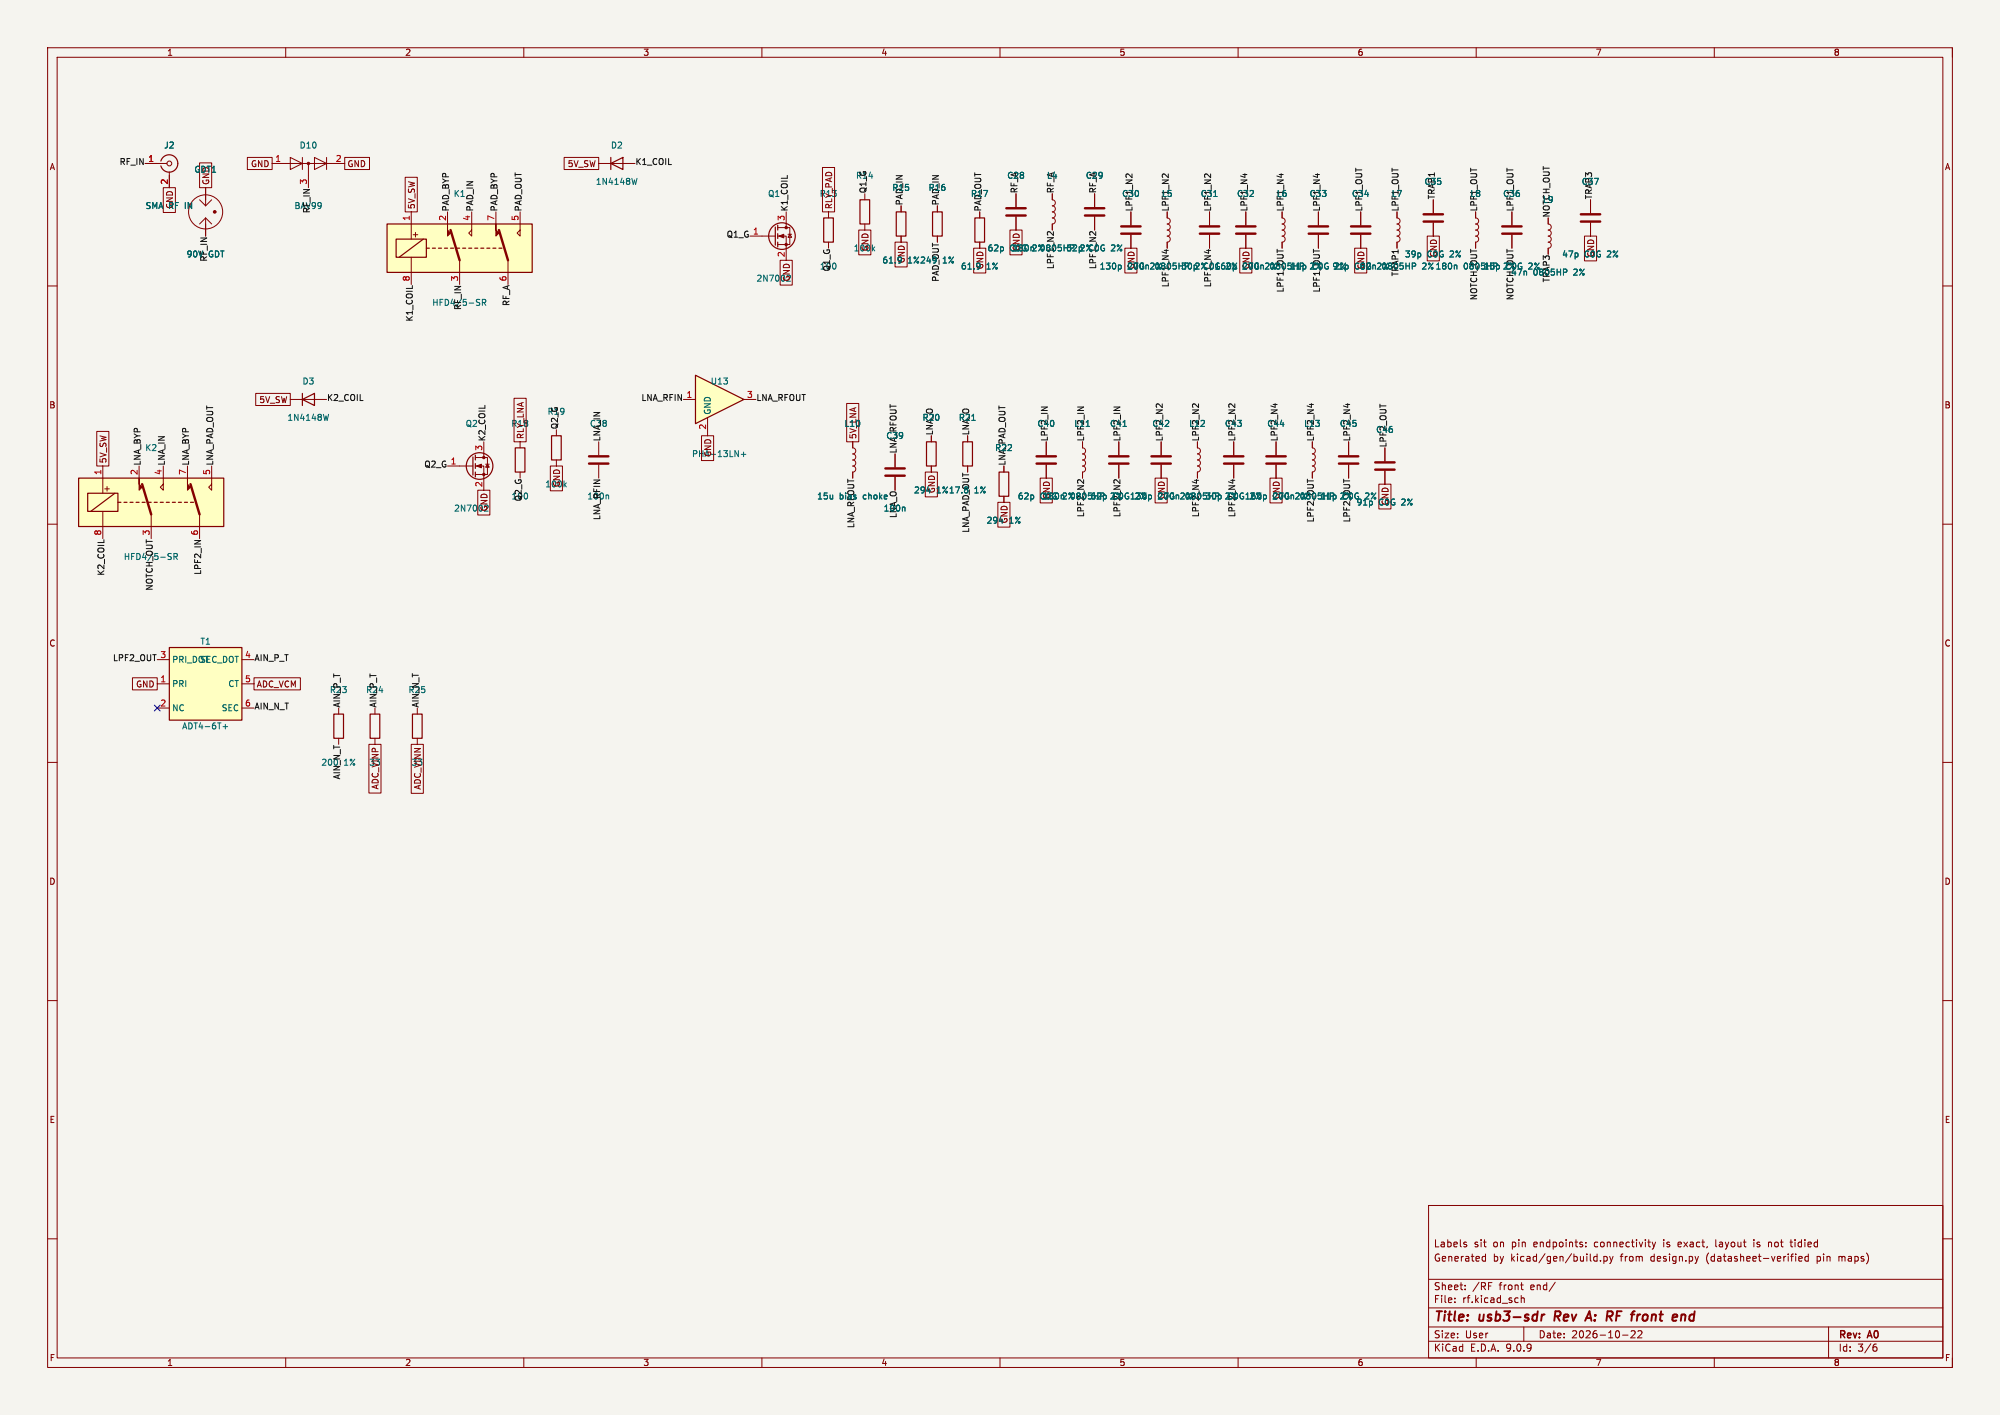
[picture p15: page 3]

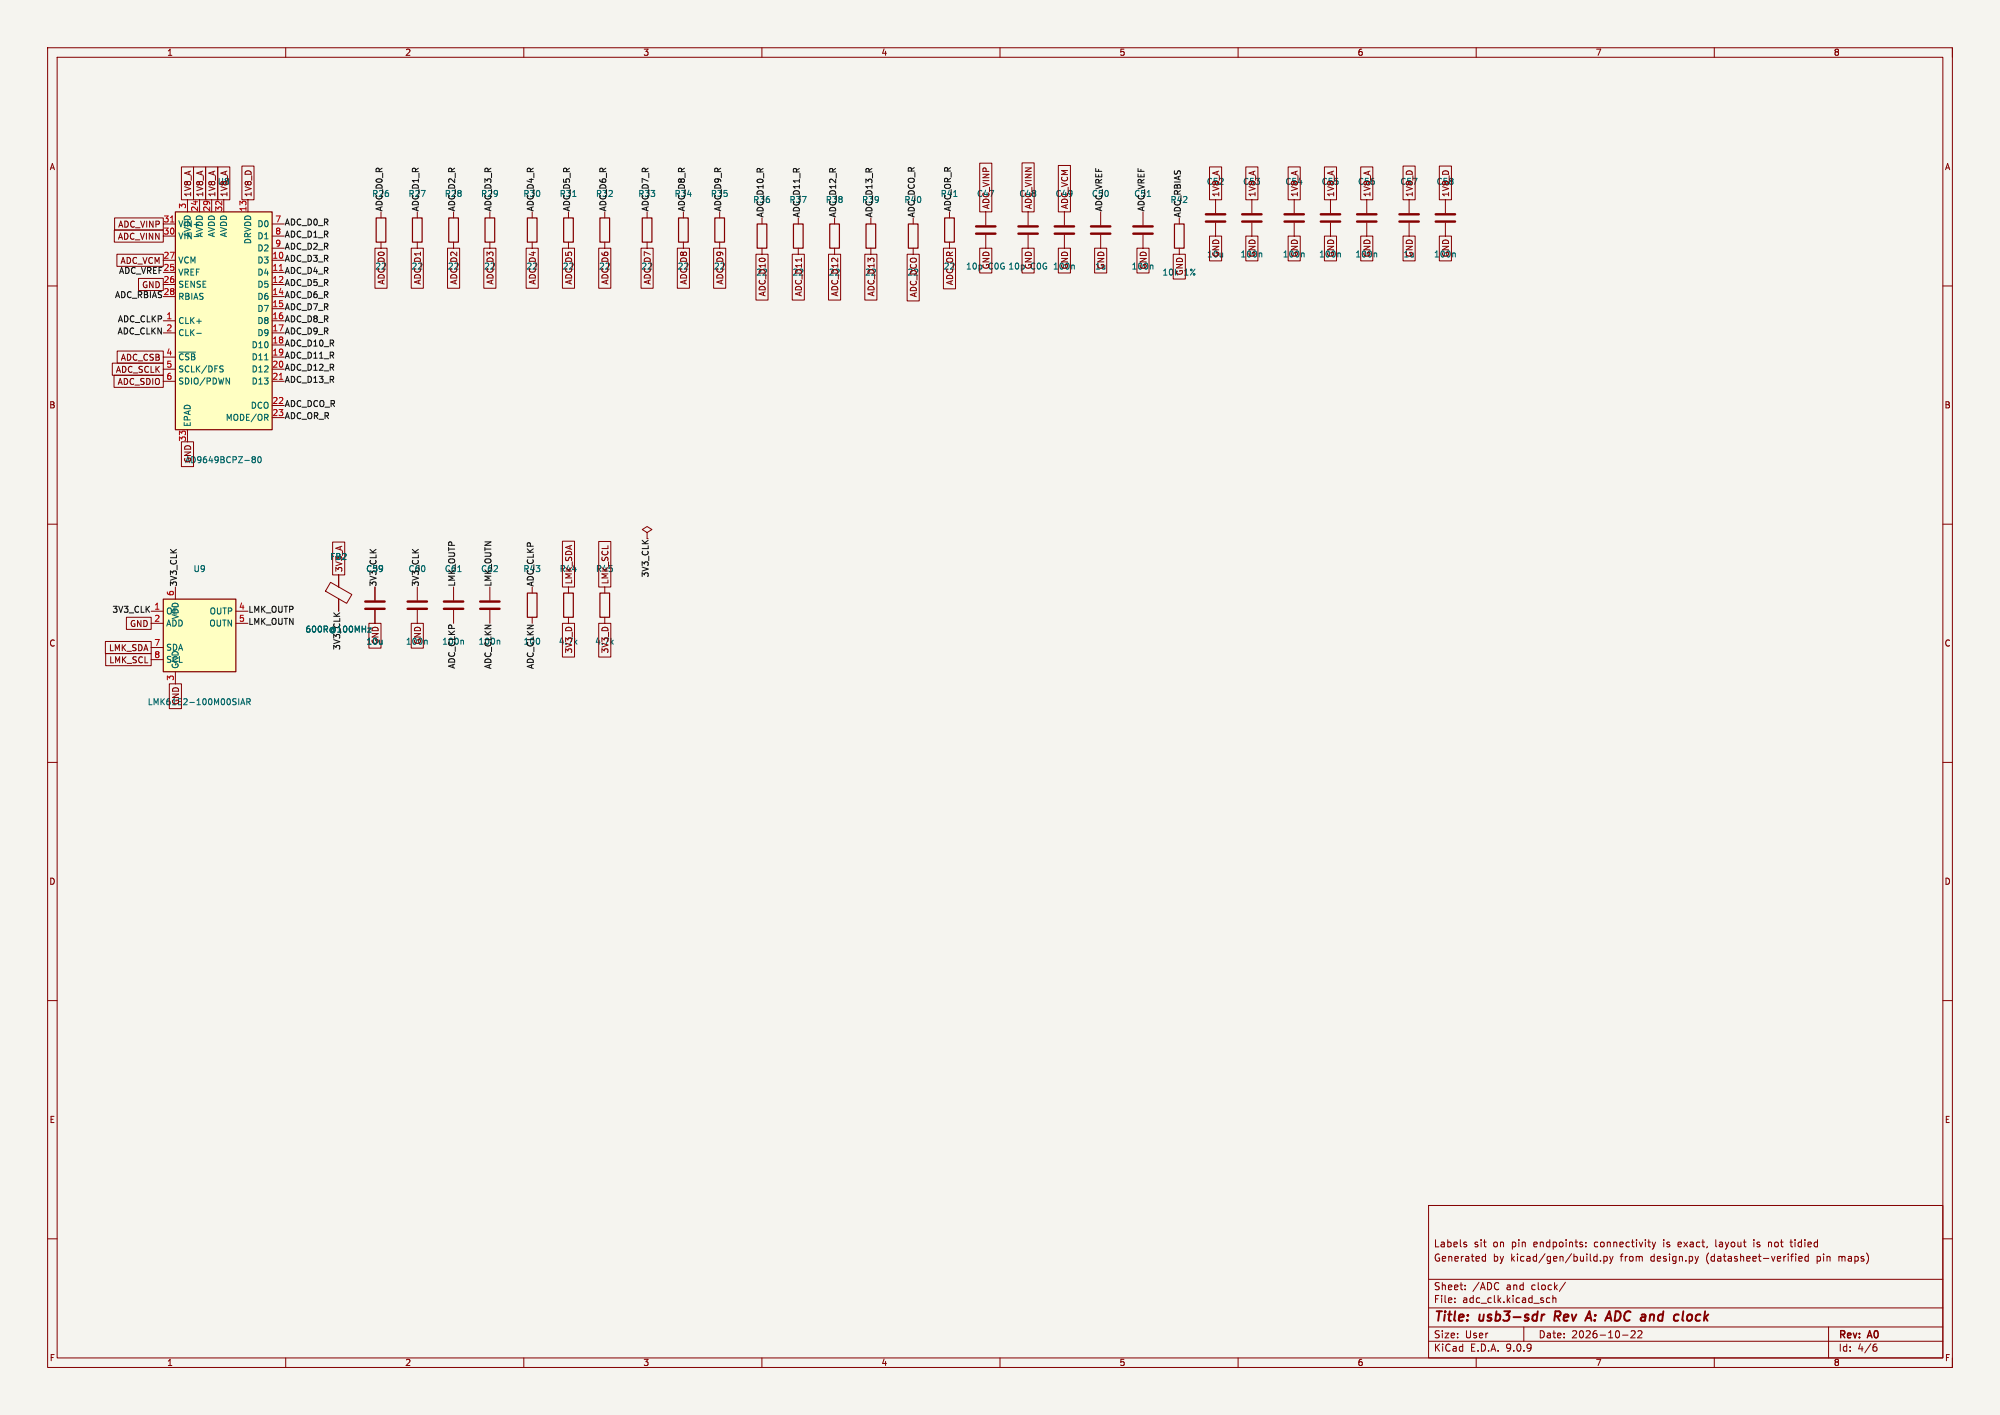
[picture p16: page 4]

3 EPAD 33 AVDD 24 AVDD 29 AVDD 32 DRVDD 13 D0 7 D1 8 D2 9 D3 10 D4 11 D5 12 D6 14 D7 15 D8 16 D9 17 D10 18 D11 19 D12 20 D13 21 DCO 22 MODE/OR 23 U8 AD9649BCPZ-80 1V8_A 1V8_A GND 1V8_A 1V8_A GND 1V8_A GND 1V8_A 1V8_A GND GND 1V8_D 1V8_A 1V8_A GNDGND 1V8_D GND GND ADC_D6 ADC_D7 ADC_D8 ADC_DCO GND ADC_VINP ADC_VINN

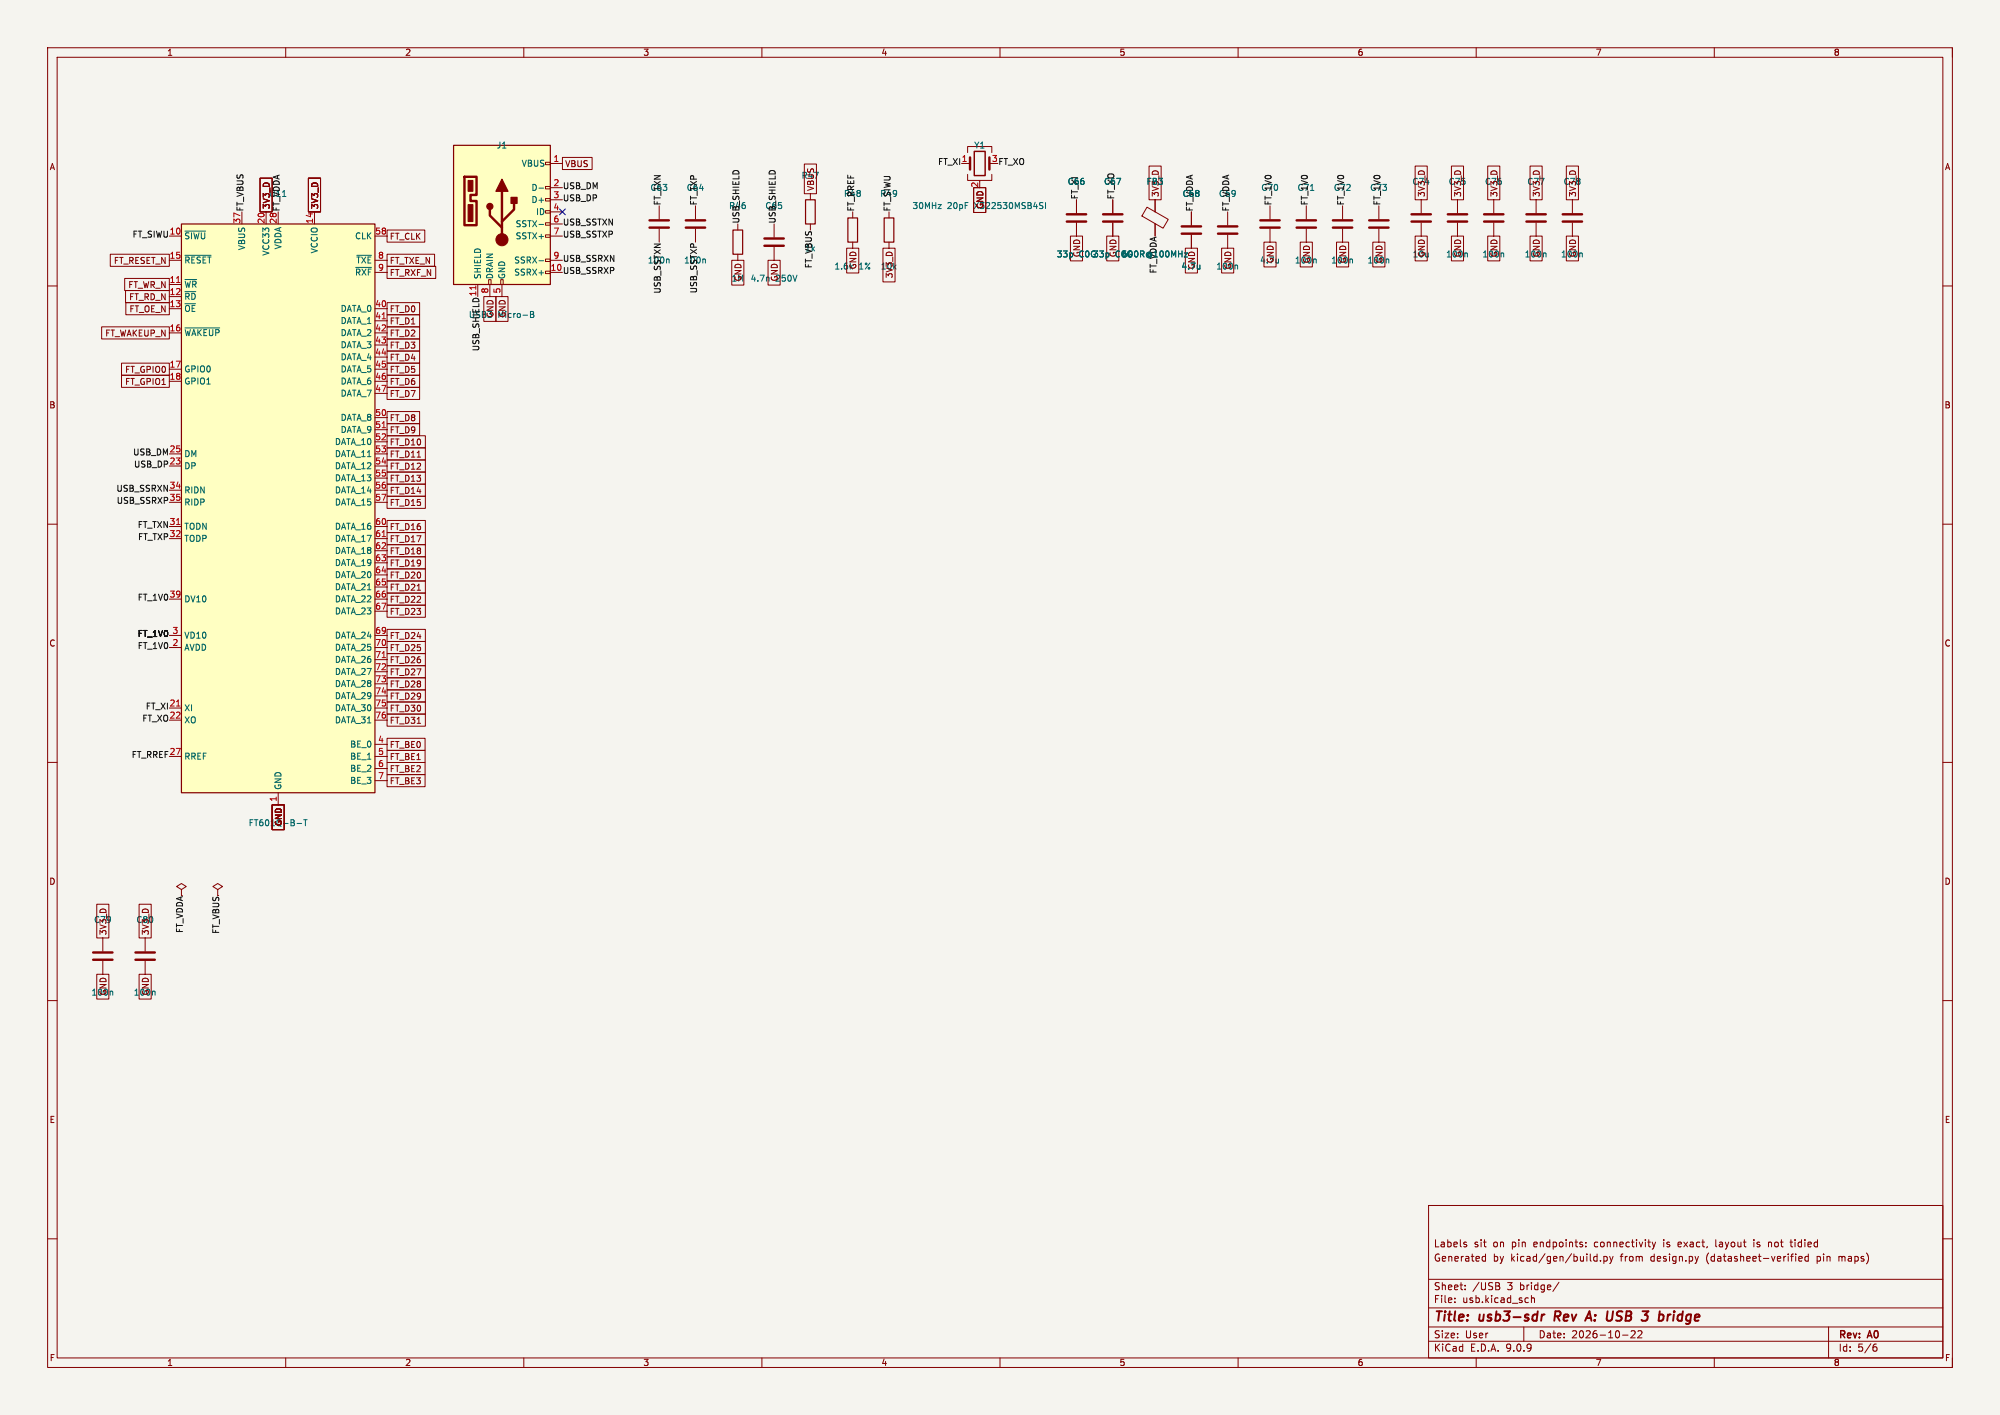
[picture p17: page 5]

1 VCCIO 14 CLK 58 ~{TXE}8 ~{RXF}9 DATA_0 40 DATA_1 41 DATA_2 42 DATA_3 43 DATA_4 44 DATA_5 45 DATA_6 46 DATA_7 47 DATA_8 50 DATA_9 51 DATA_10 52 DATA_11 53 DATA_12 54 DATA_13 55 DATA_14 56 DATA_15 57 DATA_16 60 DATA_17 61 DATA_18 62 DATA_19 63 DATA_20 64 DATA_21 65 DATA_22 66 DATA_23 67 DATA_24 69 DATA_25 70 DATA_26 71 DATA_27 72 DATA_28 73 DATA_29 74 DATA_30 75 DATA_31 76 BE_0 4 BE_1 5 BE_2 6 BE_3 7

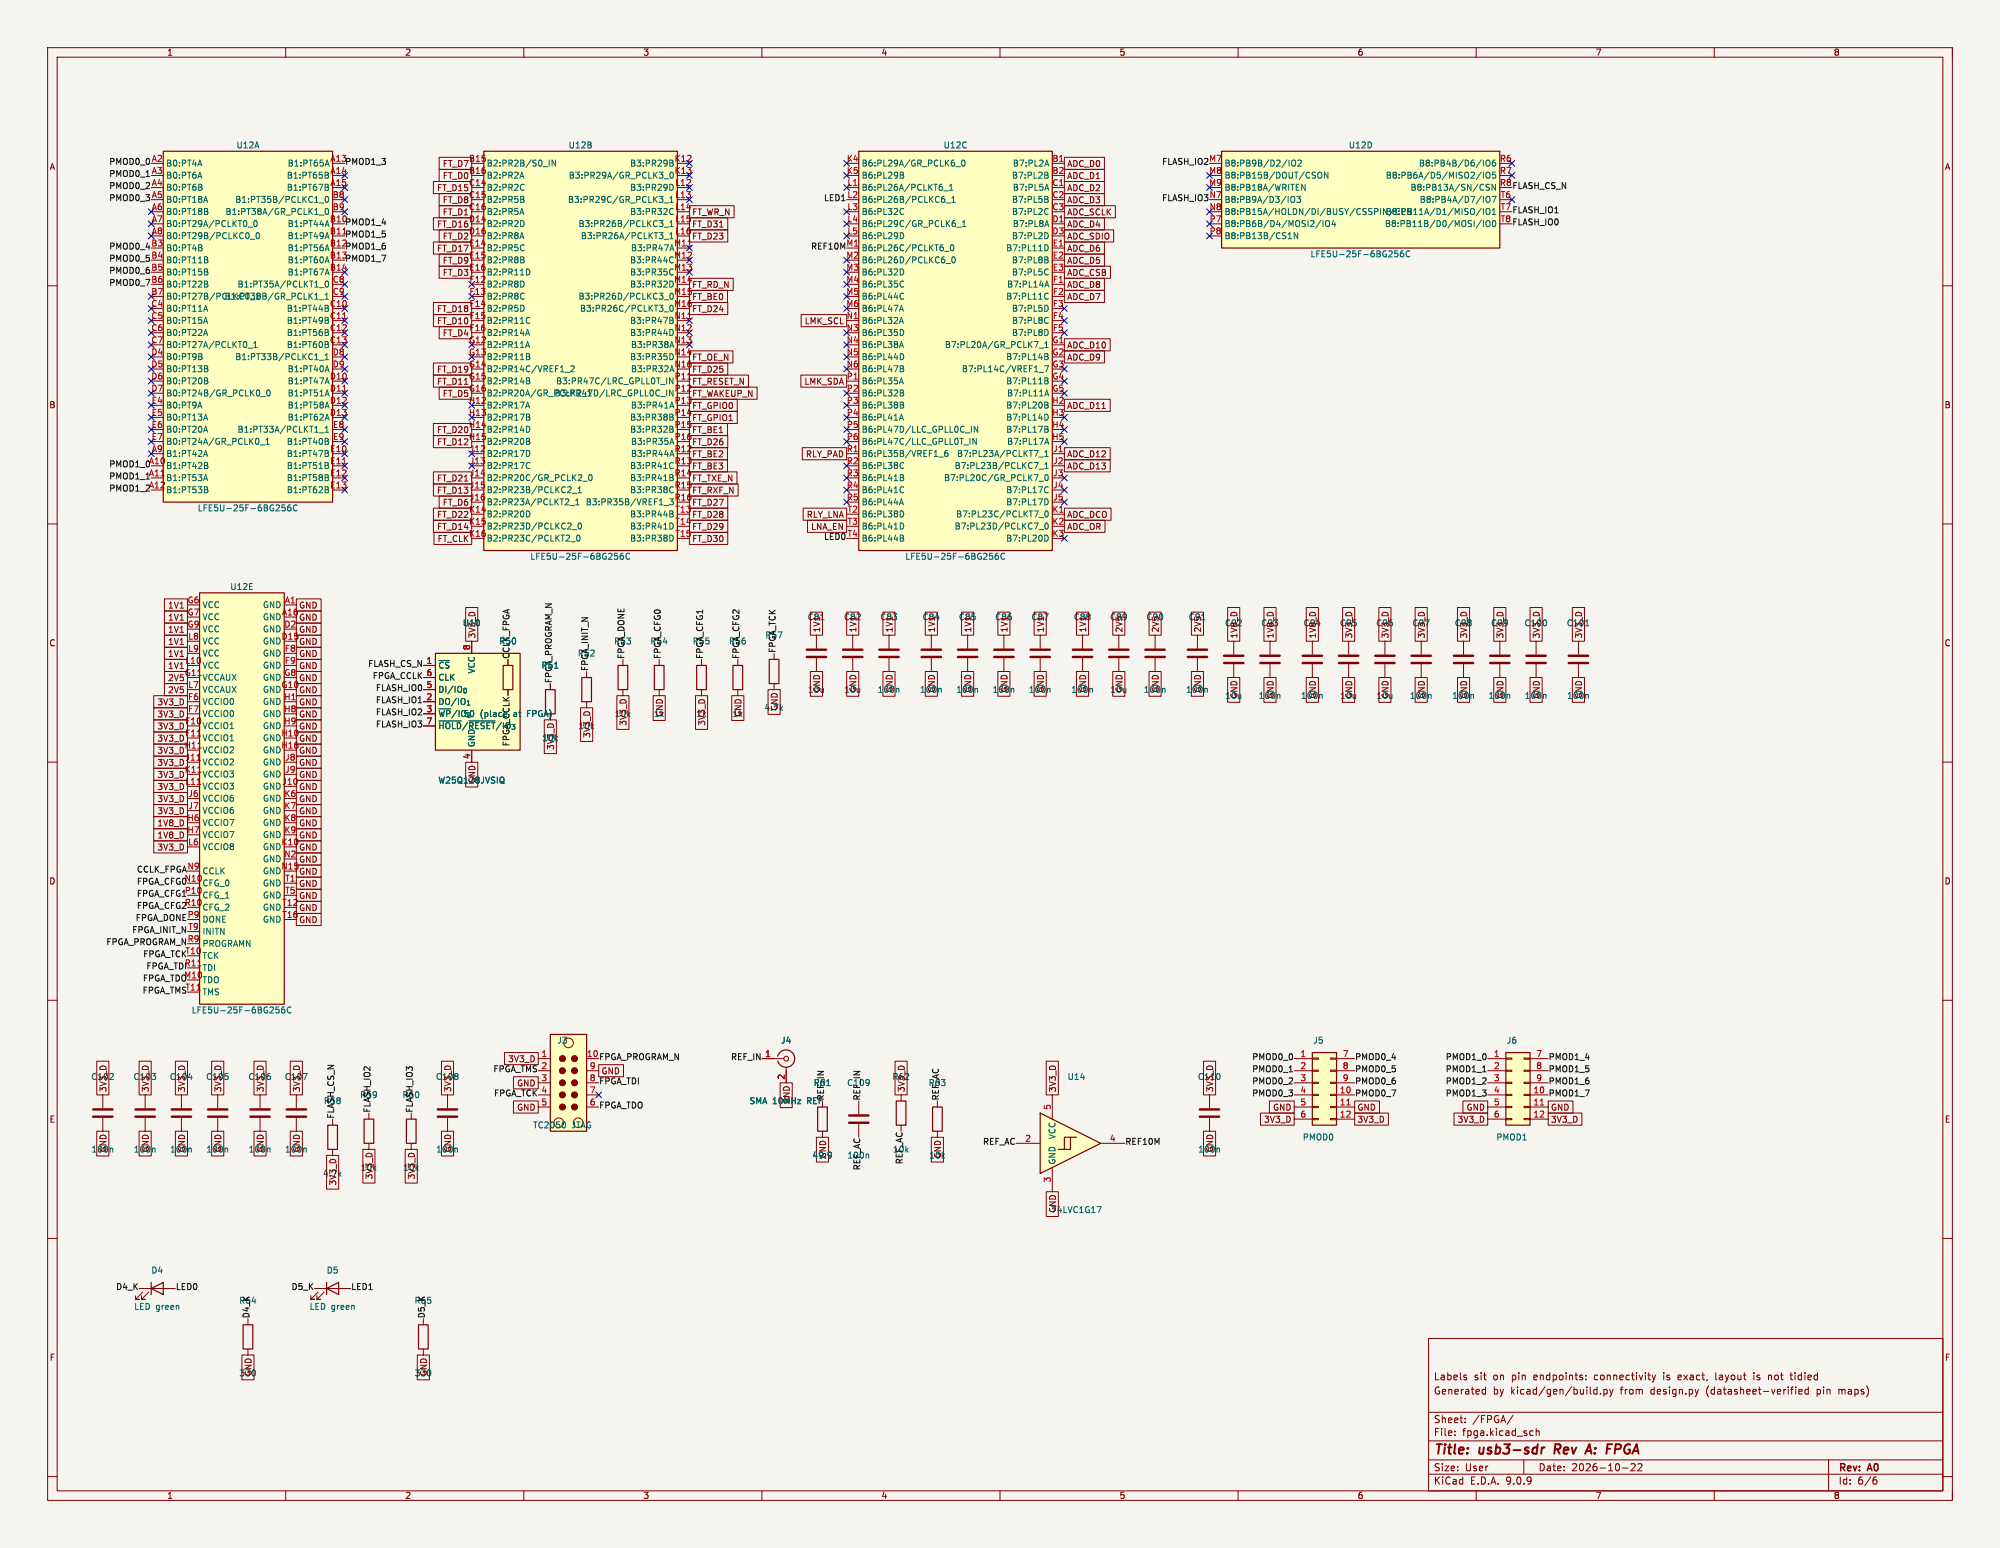
[picture p18: page 6]

10u VCC G6 VCC G7 VCC G9 VCC L8 VCC L9 VCC L10 VCCAUX G11 VCCAUX L7 VCCIO0 F6 VCCIO0 F7 VCCIO1 F10 VCCIO1 F11 VCCIO2 H11 VCCIO2 J11 VCCIO3 K11 VCCIO3 L11 VCCIO6 J6 VCCIO6 J7 VCCIO7 H6 VCCIO7 H7 VCCIO8 L6 CCLK N9 CFG_0 N10 CFG_1 P10 CFG_2 R10 DONE P9
