cfbird/usb3-sdr/kicad/work/usb3-sdr.kicad_pcb

## KiCad design kicad/work/usb3-sdr.kicad_pcb (2026-10-27)

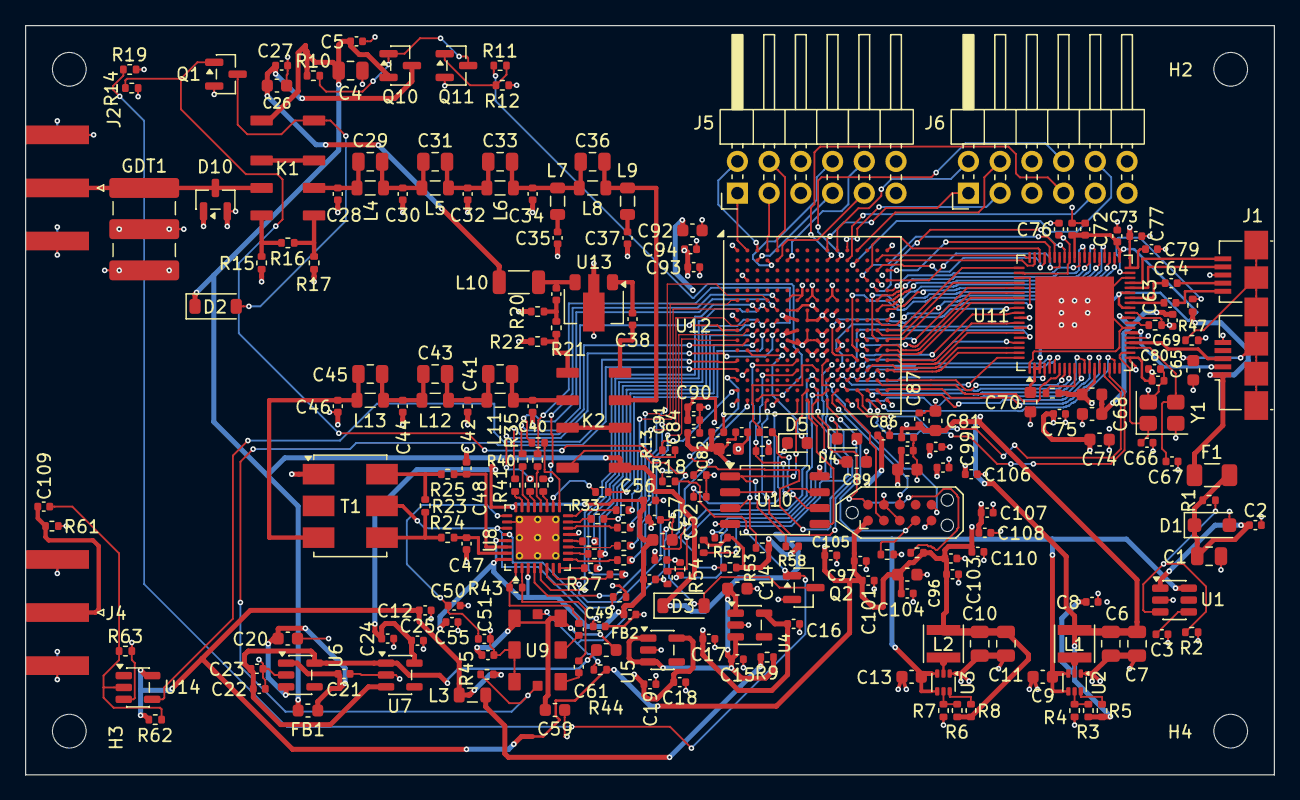
[picture p19: board usb3-sdr.kicad_pcb from above]

Board: 4 copper layers, 100.0 x 60.0 mm, 231 parts (0 on the bottom side), 203 nets.

Parts:
C1, C4, C6, C7, C10, C11: 22u; C_0805_2012Metric
C2, C5, C8, C12, C17, C19, C21, C23, C25, C27, C38, C39, C49, C51, C53, C54, C55, C56, C58, C60, C61, C62, C63, C64, C69, C71, C72, C73, C75, C76, C77, C78, C79, C80, C83, C84, C85, C86, C87, C88, C90, C91, C93, C94, C97, C98, C99, C100, C101, C102, C103, C104, C105, C106, C107, C108, C109, C110: 100n; C_0402_1005Metric
C3: 1n; C_0402_1005Metric
C9, C13, C14, C20, C26, C52, C59, C74, C81, C82, C89, C92, C95, C96: 10u; C_0603_1608Metric
C15, C16, C18, C22, C24, C50, C57: 1u; C_0402_1005Metric
C28, C40: 62p C0G 2%; C_0402_1005Metric
C29, C41: 62p C0G 2%; C_0805_2012Metric
C30, C42: 130p C0G 2%; C_0402_1005Metric
C31, C43: 30p C0G 2%; C_0805_2012Metric
C32, C44: 160p C0G 2%; C_0402_1005Metric
C33, C45: 11p C0G 2%; C_0805_2012Metric
C34, C46: 91p C0G 2%; C_0402_1005Metric
C35: 39p C0G 2%; C_0402_1005Metric
C36: 15p C0G 2%; C_0805_2012Metric
C37: 47p C0G 2%; C_0402_1005Metric
C47, C48: 10p C0G; C_0402_1005Metric
C65: 4.7n 250V; C_0603_1608Metric
C66, C67: 33p C0G; C_0402_1005Metric
C68, C70: 4.7u; C_0603_1608Metric
D1: SMF5.0A; D_SOD-123F
D2, D3: 1N4148W; D_SOD-123
D4, D5: LED green; LED_0603_1608Metric
D10: BAV99; SOT-23
F1: 1.1A; Fuse_1206_3216Metric
FB1, FB2, FB3: 600R@100MHz; L_0603_1608Metric
GDT1: 2038-09-SM (90V); GDT_Bourns_2038
H1, H2, H3, H4: MountingHole_2.7mm_M2.5
J1: USB3 Micro-B; USB3_Micro-B_Connfly_DS1104-01
J2: SMA RF IN; SMA_Amphenol_132289_EdgeMount
J3: TC2050 JTAG; Tag-Connect_TC2050-IDC-NL_2x05_P1.27mm_Vertical
J4: SMA 10MHz REF; SMA_Amphenol_132289_EdgeMount
J5: PMOD0; PinHeader_2x06_P2.54mm_Horizontal
J6: PMOD1; PinHeader_2x06_P2.54mm_Horizontal
K1, K2: HFD4/5-SR; Relay_DPDT_Hongfa_HFD4-SR
L1, L2: 1u 2A shielded; L_Taiyo-Yuden_NR-30xx
L3: 1u; L_0805_2012Metric
L4, L8, L11: 180n 0805HP 2%; L_0805_2012Metric
L5, L6, L12, L13: 270n 0805HP 2%; L_0805_2012Metric
L7: 82n 0805HP 2%; L_0805_2012Metric
L9: 47n 0805HP 2%; L_0805_2012Metric
L10: 15u bias choke; L_1206_3216Metric
Q1, Q2, Q11: 2N7002; SOT-23
Q10: AO3401A; SOT-23
R1, R2, R5, R8, R10, R12, R14, R19: 100k; R_0402_1005Metric
R3: 100k 1%; R_0402_1005Metric
R4: 120k 1%; R_0402_1005Metric
R6: 226k 1%; R_0402_1005Metric
R7: 49.9k 1%; R_0402_1005Metric
R9: 0.47; R_0402_1005Metric
R11, R13, R18, R43: 100; R_0402_1005Metric
R15, R17: 61.9 1%; R_0402_1005Metric
R16: 249 1%; R_0402_1005Metric
R20, R22: 294 1%; R_0402_1005Metric
R21: 17.8 1%; R_0402_1005Metric
R23: 200 1%; R_0402_1005Metric
R24, R25: 33; R_0402_1005Metric
R26, R27, R28, R29, R30, R31, R32, R33, R34, R35, R36, R37, R38, R39, R40, R41: 22; R_0402_1005Metric
R42: 10k 1%; R_0402_1005Metric
R44, R45, R57, R58: 4.7k; R_0402_1005Metric
R46: 1M; R_0402_1005Metric
R47, R54, R55, R56: 1k; R_0402_1005Metric
R48: 1.6k 1%; R_0402_1005Metric
R49, R51, R52, R53, R59, R60, R62, R63: 10k; R_0402_1005Metric
R50: 50 (place at FPGA); R_0402_1005Metric
R61: 49.9; R_0402_1005Metric
R64, R65: 330; R_0402_1005Metric
T1: ADT4-6T+; Mini-Circuits_CD637_H5.23mm
U1: TPS22918DBVR; SOT-23-6
U2: TPS62A02ADRLR; SOT-563
U3: TPS62A02ADRLR (forced PWM); SOT-563
U4: TLV75525PDBVR; SOT-23-5
U5, U7: TPS7A2018PDBVR; SOT-23-5
U6: TPS7A2033PDBVR; SOT-23-5
U8: AD9649BCPZ-80; LFCSP-32-1EP_5x5mm_P0.5mm_EP3.5x3.5mm_ThermalVias
U9: LMK61E2-100M00SIAR; TI_SIA0008B_QFM-8_7x5mm
U10: W25Q128JVSIQ; SOIC-8_5.3x5.3mm_P1.27mm
U11: FT601Q-B-T; QFN-76-1EP_9x9mm_P0.4mm_EP5.81x6.31mm
U12: LFE5U-25F-6BG256C; BGA-256_14.0x14.0mm_Layout16x16_P0.8mm_Ball0.45mm_Pad0.32mm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
U13: PHA-13LN+; SOT-89-3
U14: 74LVC1G17; SOT-23-5
Y1: 30MHz 20pF X322530MSB4SI; Crystal_SMD_3225-4Pin_3.2x2.5mm

Connections:
1V1: C6.1, C7.1, C8.1, C81.1, C82.1, C83.1, C84.1, C85.1, C86.1, C87.1, C88.1, L1.2, R3.1, R5.2, U12.G6, U12.G7, U12.G9, U12.L8, U12.L9, U12.L10
1V8_A: C24.1, C25.1, C52.1, C53.1, C54.1, C55.1, C56.1, U7.5, U8.3, U8.24, U8.29, U8.32
1V8_D: C18.1, C19.1, C57.1, C58.1, C92.1, C93.1, C94.1, U5.5, U8.13, U12.H6, U12.H7
2V5: C16.1, C17.1, C89.1, C90.1, C91.1, U4.5, U12.G11, U12.L7
3V3_A: C22.1, C23.1, FB2.1, U6.5, U7.1, U7.3
3V3_D: C10.1, C11.1, C12.1, C74.1, C75.1, C76.1, C77.1, C78.1, C79.1, C80.1, C95.1, C96.1, C97.1, C98.1, C99.1, C100.1, C101.1, C102.1, C103.1, C104.1, C105.1, C106.1, C107.1, C108.1, C110.1, FB3.1, J3.1, J5.6, J5.12, J6.6, J6.12, L2.2, L3.1, R6.1, R8.2, R44.2, R45.2, R49.2, R51.2, R52.2, R53.2, R55.2, R58.2, R59.2, R60.2, R62.1, U10.8, U11.14, U11.20, U11.24, U11.38, U11.49, U11.59, U11.68, U12.F6, U12.F7, U12.F10, U12.F11, U12.H11, U12.J6, U12.J7, U12.J11, U12.K11, U12.L6, U12.L11, U14.5
5V_LNA: C26.1, C27.1, L10.1, Q10.3
5V_SW: C4.1, C5.1, C9.1, C13.1, D2.1, D3.1, FB1.1, K1.1, K2.1, Q10.2, R10.1, U1.6, U2.3, U2.4, U3.3, U3.4
/ADC and clock/3V3_CLK: C59.1, C60.1, FB2.2, U9.1, U9.6
/ADC and clock/ADC_CLKN: C61.2, R43.2, U8.2
/ADC and clock/ADC_CLKP: C62.2, R43.1, U8.1
/ADC and clock/ADC_D0_R: R26.1, U8.7
/ADC and clock/ADC_D1_R: R27.1, U8.8
/ADC and clock/ADC_D2_R: R28.1, U8.9
/ADC and clock/ADC_D3_R: R29.1, U8.10
/ADC and clock/ADC_D4_R: R30.1, U8.11
/ADC and clock/ADC_D5_R: R31.1, U8.12
/ADC and clock/ADC_D6_R: R32.1, U8.14
/ADC and clock/ADC_D7_R: R33.1, U8.15
/ADC and clock/ADC_D8_R: R34.1, U8.16
/ADC and clock/ADC_D9_R: R35.1, U8.17
/ADC and clock/ADC_D10_R: R36.1, U8.18
/ADC and clock/ADC_D11_R: R37.1, U8.19
/ADC and clock/ADC_D12_R: R38.1, U8.20
/ADC and clock/ADC_D13_R: R39.1, U8.21
/ADC and clock/ADC_DCO_R: R40.1, U8.22
/ADC and clock/ADC_OR_R: R41.1, U8.23
/ADC and clock/ADC_RBIAS: R42.1, U8.28
/ADC and clock/ADC_VREF: C50.1, C51.1, U8.25
/ADC and clock/LMK_OUTN: C62.1, U9.5
/ADC and clock/LMK_OUTP: C61.1, U9.4
/FPGA/CCLK_FPGA: R50.1, U12.N9
/FPGA/D4_K: D4.1, R64.1
/FPGA/D5_K: D5.1, R65.1
/FPGA/FLASH_CS_N: R58.1, U10.1, U12.R8
/FPGA/FLASH_IO0: U10.5, U12.T8
/FPGA/FLASH_IO1: U10.2, U12.T7
/FPGA/FLASH_IO2: R59.1, U10.3, U12.M7
/FPGA/FLASH_IO3: R60.1, U10.7, U12.N7
/FPGA/FPGA_CCLK: R50.2, U10.6
/FPGA/FPGA_CFG0: R54.1, U12.N10
/FPGA/FPGA_CFG1: R55.1, U12.P10
/FPGA/FPGA_CFG2: R56.1, U12.R10
/FPGA/FPGA_DONE: R53.1, U12.P9
/FPGA/FPGA_INIT_N: R52.1, U12.T9
/FPGA/FPGA_PROGRAM_N: J3.10, R51.1, U12.R9
/FPGA/FPGA_TCK: J3.4, R57.1, U12.T10
/FPGA/FPGA_TDI: J3.8, U12.R11
/FPGA/FPGA_TDO: J3.6, U12.M10
/FPGA/FPGA_TMS: J3.2, U12.T11
/FPGA/LED0: D4.2, U12.T4
/FPGA/LED1: D5.2, U12.L2
/FPGA/PMOD0_0: J5.1, U12.A2
/FPGA/PMOD0_1: J5.2, U12.A3
/FPGA/PMOD0_2: J5.3, U12.A4
/FPGA/PMOD0_3: J5.4, U12.A5
/FPGA/PMOD0_4: J5.7, U12.B3
/FPGA/PMOD0_5: J5.8, U12.B4
/FPGA/PMOD0_6: J5.9, U12.B5
/FPGA/PMOD0_7: J5.10, U12.B6
/FPGA/PMOD1_0: J6.1, U12.A10
/FPGA/PMOD1_1: J6.2, U12.A11
/FPGA/PMOD1_2: J6.3, U12.A12
/FPGA/PMOD1_3: J6.4, U12.A13
/FPGA/PMOD1_4: J6.7, U12.B10
/FPGA/PMOD1_5: J6.8, U12.B11
/FPGA/PMOD1_6: J6.9, U12.B12
/FPGA/PMOD1_7: J6.10, U12.B13
/FPGA/REF10M: U12.M1, U14.4
/FPGA/REF_AC: C109.2, R62.2, R63.1, U14.2
/FPGA/REF_IN: C109.1, J4.1, R61.1
/Power/3V3_D_F: C14.1, C15.1, R9.2, U4.1, U4.3, U5.1, U5.3
/Power/3V3_PF: L3.2, R9.1
/Power/5V_A: C20.1, C21.1, FB1.2, U6.1, U6.3
/Power/FB_1V1: R3.2, R4.1, U2.5
/Power/FB_3V3: R6.2, R7.1, U3.5
/Power/LS_CT: C3.1, U1.4
/Power/LS_ON: R1.2, R2.1, U1.3
/Power/PG_1V1: R5.1, U2.6
/Power/PG_3V3: R8.1, U3.6
/Power/Q10_G: Q10.1, Q11.3, R10.2
/Power/Q11_G: Q11.1, R11.2, R12.1
/Power/SW_1V1: L1.1, U2.2
/Power/SW_3V3: L2.1, U3.2
/Power/VBUS_F: C1.1, C2.1, D1.1, F1.2, R1.1, U1.1
/RF front end/AIN_N_T: R23.2, R25.1, T1.6
/RF front end/AIN_P_T: R23.1, R24.1, T1.4
/RF front end/K1_COIL: D2.2, K1.8, Q1.3
/RF front end/K2_COIL: D3.2, K2.8, Q2.3
/RF front end/LNA_BYP: K2.2, K2.7
/RF front end/LNA_IN: C38.1, K2.4
/RF front end/LNA_O: C39.2, R20.1, R21.1
/RF front end/LNA_PAD_OUT: K2.5, R21.2, R22.1
/RF front end/LNA_RFIN: C38.2, U13.1
/RF front end/LNA_RFOUT: C39.1, L10.2, U13.3
/RF front end/LPF1_N2: C29.2, C30.1, C31.1, L4.2, L5.1
/RF front end/LPF1_N4: C31.2, C32.1, C33.1, L5.2, L6.1
/RF front end/LPF1_OUT: C33.2, C34.1, C36.1, L6.2, L7.1, L8.1
/RF front end/LPF2_IN: C40.1, C41.1, K2.6, L11.1
/RF front end/LPF2_N2: C41.2, C42.1, C43.1, L11.2, L12.1
/RF front end/LPF2_N4: C43.2, C44.1, C45.1, L12.2, L13.1
/RF front end/LPF2_OUT: C45.2, C46.1, L13.2, T1.3
/RF front end/NOTCH_OUT: C36.2, K2.3, L8.2, L9.1
/RF front end/PAD_BYP: K1.2, K1.7
/RF front end/PAD_IN: K1.4, R15.1, R16.1
/RF front end/PAD_OUT: K1.5, R16.2, R17.1
/RF front end/Q1_G: Q1.1, R13.2, R14.1
/RF front end/Q2_G: Q2.1, R18.2, R19.1
/RF front end/RF_A: C28.1, C29.1, K1.6, L4.1
/RF front end/RF_IN: D10.3, GDT1.1, J2.1, K1.3
/RF front end/TRAP1: C35.1, L7.2
/RF front end/TRAP3: C37.1, L9.2
/USB 3 bridge/FT_1V0: C70.1, C71.1, C72.1, C73.1, U11.2, U11.3, U11.30, U11.33, U11.39, U11.48
/USB 3 bridge/FT_RREF: R48.1, U11.27
/USB 3 bridge/FT_SIWU: R49.1, U11.10
/USB 3 bridge/FT_TXN: C63.1, U11.31
/USB 3 bridge/FT_TXP: C64.1, U11.32
/USB 3 bridge/FT_VBUS: R47.2, U11.37
/USB 3 bridge/FT_VDDA: C68.1, C69.1, FB3.2, U11.28
/USB 3 bridge/FT_XI: C66.1, U11.21, Y1.1
/USB 3 bridge/FT_XO: C67.1, U11.22, Y1.3
/USB 3 bridge/USB_D_N: J1.2, U11.25
/USB 3 bridge/USB_D_P: J1.3, U11.23
/USB 3 bridge/USB_SHIELD: C65.1, J1.11, R46.1
/USB 3 bridge/USB_SSRXN: J1.9, U11.34
/USB 3 bridge/USB_SSRXP: J1.10, U11.35
/USB 3 bridge/USB_SSTXN: C63.2, J1.6
/USB 3 bridge/USB_SSTXP: C64.2, J1.7
ADC_CSB: U8.4, U12.H2
ADC_D0: R26.2, U12.G4
ADC_D1: R27.2, U12.H3
ADC_D2: R28.2, U12.F4
ADC_D3: R29.2, U12.J3
ADC_D4: R30.2, U12.J2
ADC_D5: R31.2, U12.H4
ADC_D6: R32.2, U12.F1
ADC_D7: R33.2, U12.K3
ADC_D8: R34.2, U12.G1
ADC_D9: R35.2, U12.G5
ADC_D10: R36.2, U12.J4
ADC_D11: R37.2, U12.F5
ADC_D12: R38.2, U12.H5
ADC_D13: R39.2, U12.J5
ADC_DCO: R40.2, U12.J1
ADC_OR: R41.2, U12.K2
ADC_SCLK: U8.5, U12.G3
ADC_SDIO: U8.6, U12.K1
ADC_VCM: C49.1, T1.5, U8.27
ADC_VINN: C48.1, R25.2, U8.30
ADC_VINP: C47.1, R24.2, U8.31
FT_BE0: U11.4, U12.P12
FT_BE1: U11.5, U12.P13
FT_BE2: U11.6, U12.P14
FT_BE3: U11.7, U12.P15
FT_CLK: U11.58, U12.J16
FT_D0: U11.40, U12.K16
FT_D1: U11.41, U12.L13
FT_D2: U11.42, U12.K15
FT_D3: U11.43, U12.G16
FT_D4: U11.44, U12.G15
FT_D5: U11.45, U12.F16
FT_D6: U11.46, U12.F15
FT_D7: U11.47, U12.E16
FT_D8: U11.50, U12.E15
FT_D9: U11.51, U12.D16
FT_D10: U11.52, U12.D14
FT_D11: U11.53, U12.C16
FT_D12: U11.54, U12.C15
FT_D13: U11.55, U12.C14
FT_D14: U11.56, U12.B16
FT_D15: U11.57, U12.B15
FT_D16: U11.60, U12.H15
FT_D17: U11.61, U12.J15
FT_D18: U11.62, U12.K14
FT_D19: U11.63, U12.L14
FT_D20: U11.64, U12.L15
FT_D21: U11.65, U12.L16
FT_D22: U11.66, U12.M13
FT_D23: U11.67, U12.M14
FT_D24: U11.69, U12.M15
FT_D25: U11.70, U12.N11
FT_D26: U11.71, U12.M16
FT_D27: U11.72, U12.N12
FT_D28: U11.73, U12.N13
FT_D29: U11.74, U12.N14
FT_D30: U11.75, U12.N16
FT_D31: U11.76, U12.P11
FT_GPIO0: U11.17, U12.T14
FT_GPIO1: U11.18, U12.T15
FT_OE_N: U11.13, U12.R15
FT_RD_N: U11.12, U12.R14
FT_RESET_N: U11.15, U12.R16
FT_RXF_N: U11.9, U12.R12
FT_TXE_N: U11.8, U12.P16
FT_WAKEUP_N: U11.16, U12.T13
FT_WR_N: U11.11, U12.R13
GND: C1.2, C2.2, C3.2, C4.2, C5.2, C6.2, C7.2, C8.2, C9.2, C10.2, C11.2, C12.2, C13.2, C14.2, C15.2, C16.2, C17.2, C18.2, C19.2, C20.2, C21.2, C22.2, C23.2, C24.2, C25.2, C26.2, C27.2, C28.2, C30.2, C32.2, C34.2, C35.2, C37.2, C40.2, C42.2, C44.2, C46.2, C47.2, C48.2, C49.2, C50.2, C51.2, C52.2, C53.2, C54.2, C55.2, C56.2, C57.2, C58.2, C59.2, C60.2, C65.2, C66.2, C67.2, C68.2, C69.2, C70.2, C71.2, C72.2, C73.2, C74.2, C75.2, C76.2, C77.2, C78.2, C79.2, C80.2, C81.2, C82.2, C83.2, C84.2, C85.2, C86.2, C87.2, C88.2, C89.2, C90.2, C91.2, C92.2, C93.2, C94.2, C95.2, C96.2, C97.2, C98.2, C99.2, C100.2, C101.2, C102.2, C103.2, C104.2, C105.2, C106.2, C107.2, C108.2, C110.2, D1.2, D10.1, D10.2, GDT1.2, GDT1.3, J1.5, J1.8, J2.2, J3.3, J3.5, J3.9, J4.2, J5.5, J5.11, J6.5, J6.11, Q1.2, Q2.2, Q11.2, R2.2, R4.2, R7.2, R12.2, R14.2, R15.2, R17.2, R19.2, R20.2, R22.2, R42.2, R46.2, R48.2, R54.2, R56.2, R57.2, R61.2, R63.2, R64.2, R65.2, T1.1, U1.2, U2.1, U3.1, U4.2, U5.2, U6.2, U7.2, U8.26, U8.33, U9.2, U9.3, U10.4, U11.1, U11.26, U11.29, U11.36, U11.77, U12.A1, U12.A16, U12.D2, U12.D15, U12.F8, U12.F9, U12.G8, U12.G10, U12.H1, U12.H8, U12.H9, U12.H10, U12.H16, U12.J8, U12.J9, U12.J10, U12.K6, U12.K7, U12.K8, U12.K9, U12.K10, U12.N2, U12.N15, U12.T1, U12.T5, U12.T12, U12.T16, U13.2, U14.3, Y1.2, Y1.4
LMK_SCL: R45.1, U9.8, U12.N1
LMK_SDA: R44.1, U9.7, U12.P1
LNA_EN: R11.1, U12.T3
RLY_LNA: R18.1, U12.T2
RLY_PAD: R13.1, U12.R1
VBUS: F1.1, J1.1, R47.1
