cfbird/usb3-sdr/(commit log)

2026-10-25 usb3-sdr snapshot: spec, gateware, KiCad schematic + placed/fanned-out PCB ready for DeepPCB
    State at 2026-10-23: schematic verified (203/203 nets, 71/71 LPF pins), PCB critical
    routes (RF chain, USB3 SS) scripted and locked, DRC clean except inherent SMA edge items.
    See STATUS.md for next steps.
    [FPGA-SC-02033-2-0-ECP5U-25-Pinout.csv, adc_clk.kicad_sch, bom.csv, fpga.kicad_sch, power.kicad_sch, rf.kicad_sch, usb.kicad_sch, usb3-sdr.kicad_pcb]
2026-10-25 Bus pin swap, FT601 IO registers, ADC clock layout, working board and fan-out tooling
    - FPGA ball re-assignment (AGY, verified): FT601 and ADC buses planar; LPF, design.py, schematic, netlist synced.
    - Gateware: FT601 outputs/tristates in IOLOGIC on a +112.5 deg PLL clock; AD9649 DCO inverted at boot.
    - ADC sample clock laid out on F.Cu with swapped polarity; BOM U9 corrected to the 8-pin I2C LMK61E2.
    - kicad/work: DeepPCB run 2 board plus scripted patches (buck, In2 GND fill, VCCAUX, clock); DeepPCB snapshots.
    - kicad/gen: patch, repair, routing and fan-out scripts (fanout_apply, fanout_trial, place_free, escape_apply).
    - notes/pinswap, notes/fanout: briefs, AGY results and Claude's reviews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
    [adc_clk.kicad_sch, bom.csv, fpga.kicad_sch, power.kicad_sch, r1_deeppcb_raw.kicad_pcb, r2_deeppcb_routed.kicad_pcb, r2_input.kicad_pcb, rf.kicad_sch]
2026-10-25 Fan-out v3 applied, DeepPCB runs 3/4 adopted, bus length rules
    - AGY fan-out plan v3 (with Claude's fixes) applied: power islands clear of
    the BGA escape rings, all islands fill, 0 copper conflicts.
    - DeepPCB run 3 + run 4 adopted into kicad/work: 54 unconnected, DRC clean
    apart from the known SMA edge items; raw inputs/outputs in kicad/deeppcb.
    - AGY ADC resistor moves applied; ADC bus re-routed, all routed FT601/ADC
    nets pass the corrected length/skew rules (notes/route).
    - New tools: apply_moves.py, edge_keepout.py, lane_clear.py.
    [r3_deeppcb_routed.kicad_pcb, r3_input.kicad_pcb, r4_deeppcb_routed.kicad_pcb, r4_input.kicad_pcb, usb3-sdr.kicad_pcb, work_after_r3.kicad_pcb, work_before_fanout.kicad_pcb, work_before_r4.kicad_pcb]
2026-10-25 U11 escape plan, USB2 pair route, FT601 centre-pad vias
    - AGY U11 (FT601) escape plan applied: all 19 stuck FT601 nets routed,
    every FT bus net passes length/skew (11-28 mm).
    - USB2 pair hand-routed (D- crosses under D+ on B.Cu), C65 moved off the
    pair path, VBUS sense branch re-routed.
    - U11 centre pad had no vias to the GND plane: 7 GND vias added.
    - kicad/gen/u11_trial.py: trial any moves/rips/tracks/vias plan on a temp
    copy with real fill + DRC.
    - Work board: 33 unconnected, copper DRC clean, parity 0.
    [usb3-sdr.kicad_pcb, work_before_u11.kicad_pcb]
2026-10-26 Route U12 south-west region: board fully routed
    AGY's U12 south-west plan round 2 (ADC bus, ADC SPI, FPGA config, flash, LED1,
    LMK_SDA, rail stubs) closes the last 33 connections: 0 unconnected, schematic
    parity 0, no new copper DRC errors. ADC and FT601 timing pass.
    - New kicad/gen/rf_spacing.py: digital copper vs RF-path copper, same layer.
    Round 1 ran ADC lines 0.21 mm beside NOTCH_OUT; round 2 keeps >= 0.65 mm
    and also clears the pre-existing REF10M / LPF2_OUT and ADC_D8 / NOTCH_OUT
    runs. Seven ADC nets run at 0.10 mm width beside NOTCH_OUT.
    - In2 rect x 134-152, y 108-134 retargeted from 1V8_A to GND: it had no loads
    and its only feed was ripped by the plan (isolated copper).
    -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
    [r5_input.kicad_pcb, usb3-sdr.kicad_pcb, work_before_u12sw.kicad_pcb]
2026-10-26 Remove dangling vias and stubs from the work board
    8 vias connected on one layer only (1V1 x2, 2V5 x2, 3V3_D, 5V_SW, FT_D13,
    LNA_EN) and 3 stubs left loose by them (3V3_D 0.1 + 1.0 mm, FT_D13 0.57 mm
    escape stub). DRC after: 0 unconnected, parity 0, no dangling copper; only
    the 10 SMA edge items and silk warnings remain. Timing and RF spacing
    unchanged (FT_D13 16.92 mm, pass). Backup kicad/deeppcb/work_before_cleanup.
    [usb3-sdr.kicad_pcb, work_before_cleanup.kicad_pcb]
2026-10-27 Clean up silkscreen reference labels
    New kicad/gen/silk_refs.py re-places footprint reference labels so they clear
    pads, silk outlines, other labels and the board edge (0.5 mm), using the
    stroked glyph box. A spot is rejected if the label sits nearer another part's
    pads than its own. 189 labels placed (24 at 0.8 mm), 42 hidden where no
    unambiguous spot exists (they keep their F.Fab reference). List in
    notes/silk_refs_report.json.
    DRC: 343 silk warnings -> 0; only the 10 SMA edge items remain. 0 unconnected,
    parity 0; timing and RF spacing unchanged. Backup kicad/deeppcb/work_before_silk.
    [usb3-sdr.kicad_pcb, work_before_silk.kicad_pcb]
2026-10-28 SMA edge check notes; STATUS resume checklist before pause
    J2/J4 match the KiCad footprint and 3D model (flange face on the board
    edge); the Amphenol drawing check is still open. STATUS.md gains a
    re-verified state snapshot, ordered next steps and working rules.
